FLRHW/ktest/output/reports/browse/images/cat_blender_bare_top_ktest-3D_blenderbare_top.png

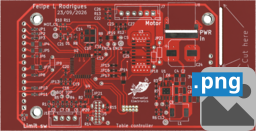
output/reports/browse/images/cat_blender_bare_top_ktest-3D_blenderbare_top.png
