FLRHW/ktest/output/reports/browse/images/cat_blender_bare_bottom_ktest-3D_blenderbare_bottom.png

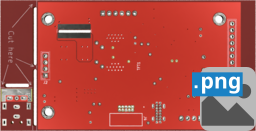
output/reports/browse/images/cat_blender_bare_bottom_ktest-3D_blenderbare_bottom.png
