FLRHW/ktest/output/reports/ktest-drc.html

Logo

(https://github.com/INTI-CMNB/KiBot/) | DRC report for ktest
| PCB: ktest Revision: 1.0.1 Date: 2026-10-10T20:06:10 KiCad Version: 10.0.5 | Errors: 0 Warnings: 4 Total: 4

Violations

Type | Description | Details
silk_over_copper | Silkscreen clipped by solder mask | @(197.425 mm, 77.951 mm): Segment of J6 on F.Silkscreen @(196.493 mm, 77.239 mm): Rectangle on F.Mask
silk_over_copper | Silkscreen clipped by solder mask | @(197.425 mm, 79.951 mm): Segment of J6 on F.Silkscreen @(196.493 mm, 77.239 mm): Rectangle on F.Mask
silk_over_copper | Silkscreen clipped by solder mask | @(186.925 mm, 79.951 mm): Segment of J6 on F.Silkscreen @(186.079 mm, 77.239 mm): Rectangle on F.Mask
silk_over_copper | Silkscreen clipped by solder mask | @(187.925 mm, 77.951 mm): Segment of J6 on F.Silkscreen @(186.079 mm, 77.239 mm): Rectangle on F.Mask

Generated by KiBot (https://github.com/INTI-CMNB/KiBot/) v1.9.1
