FLRHW/ktest/output/reports/ktest-erc.html

Logo

(https://github.com/INTI-CMNB/KiBot/) | ERC report for ktest
| Schematic: ktest Revision: 1.0.1 Date: 2026-10-10T20:06:06 KiCad Version: 10.0.5 | Errors: 0 Warnings: 0 Total: 0

✔

Generated by KiBot (https://github.com/INTI-CMNB/KiBot/) v1.9.1
