FLRHW/ktest/output/3d/ktest-3D_blenderangled_bottom.png

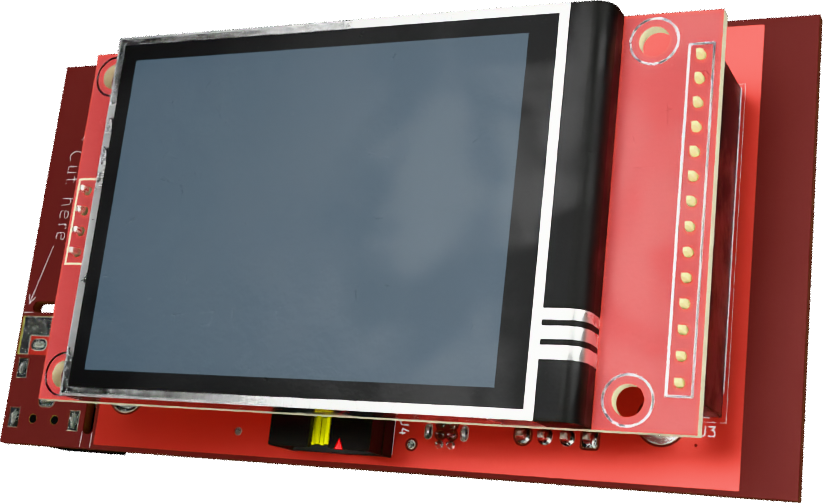
output/3d/ktest-3D_blenderangled_bottom.png
