FLRHW/ktest/output/3d/ktest-3D_blenderangled_top.png

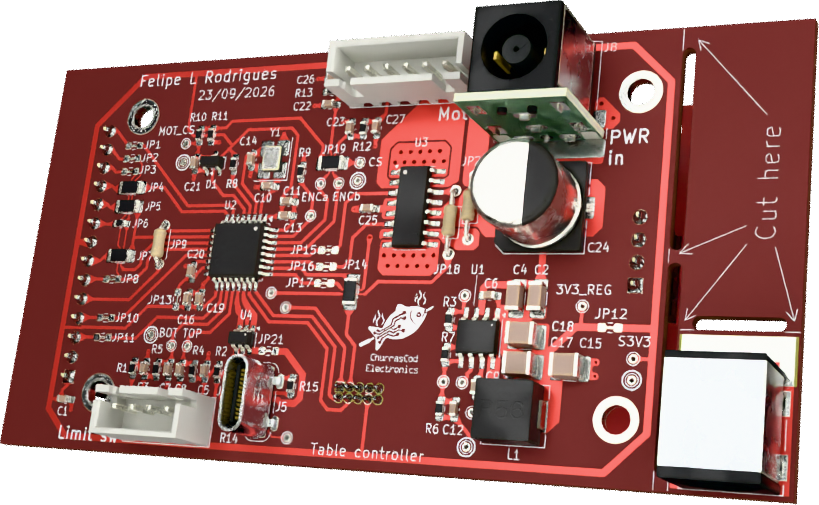
output/3d/ktest-3D_blenderangled_top.png
