FLRHW/ktest/output/3d/ktest-3D_blenderbare_bottom.png

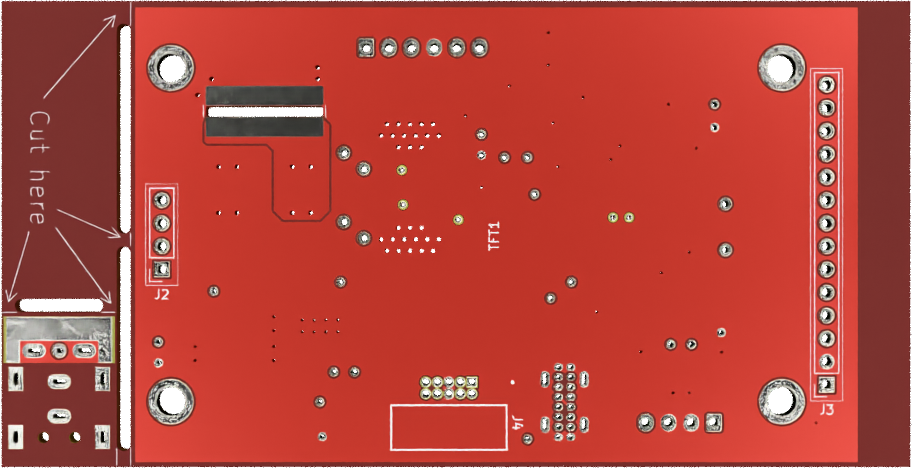
output/3d/ktest-3D_blenderbare_bottom.png
