FLRHW/ktest/output/3d/ktest-3D_blenderbare_top.png

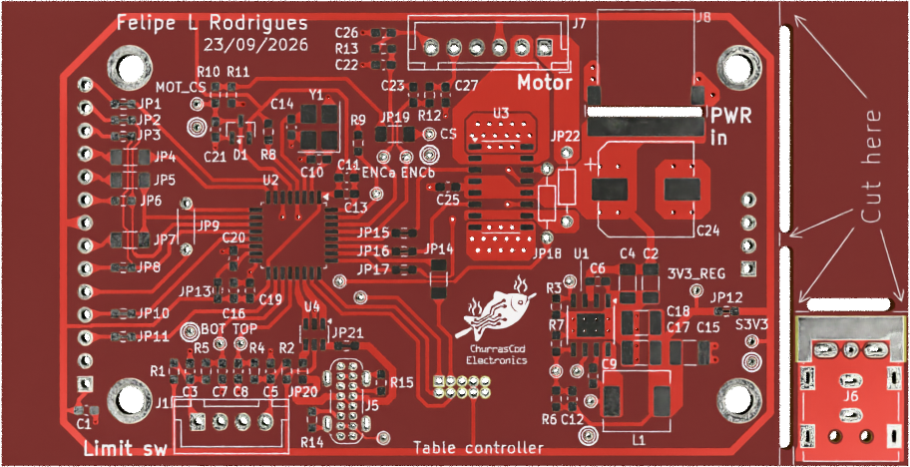
output/3d/ktest-3D_blenderbare_top.png
