FLRHW/ktest/output/3d/ktest-3D_blenderbottom.png

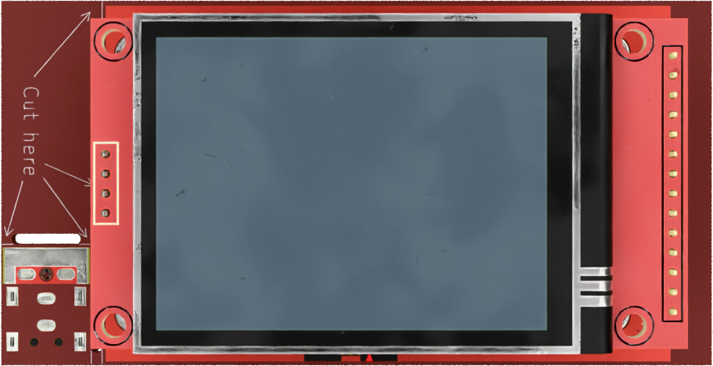
output/3d/ktest-3D_blenderbottom.png
