FLRHW/ktest/output/3d/ktest-3D_blendertop.png

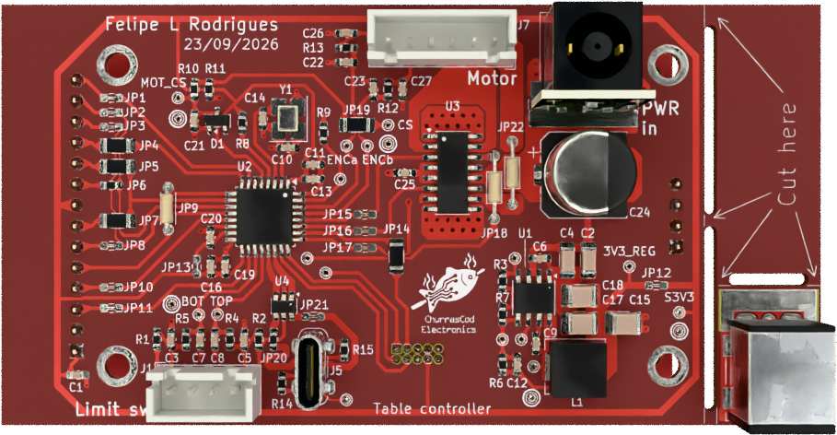
output/3d/ktest-3D_blendertop.png
