FLRHW/ktest/output/reports/browse/images/cat_blender_angled_bottom_ktest-3D_blenderangled_bottom.png

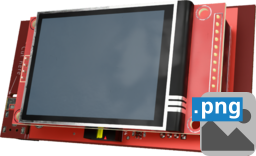
output/reports/browse/images/cat_blender_angled_bottom_ktest-3D_blenderangled_bottom.png
