FLRHW/ktest/output/reports/browse/images/cat_blender_bottom_ktest-3D_blenderbottom.png

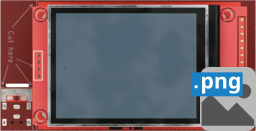
output/reports/browse/images/cat_blender_bottom_ktest-3D_blenderbottom.png
