FLRHW/ktest/output/reports/browse/images/cat_Schematic_ktest-schematic.png

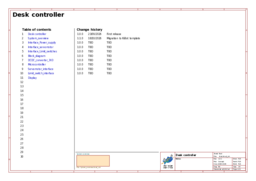
output/reports/browse/images/cat_Schematic_ktest-schematic.png
