FLRHW/ktest/output/tables/ktest-assembly-bom-bottom-fitted.csv

References | Qty | Value | Footprint | MPN | Manufacturer | Status
J2 | 1 | 01x04 socket | PinSocket_1x04_P2.54mm_Vertical | Generic | Generic
J3 | 1 | 01x14 socket | PinSocket_1x14_P2.54mm_Vertical | Generic | Generic
J4 | 1 | HX JN1.27-2x5 WZ H4.9 | JN1.27-2x5 WZ H4.9 | Hanxia | HX JN1.27-2x5 WZ H4.9
TFT1 | 1 | TFT_2.4in_320x240 | Display_240x320_ILI9341_2.4in_no_pads | ILI9341_320x240 | TENSTAR ROBOT
