FLRHW/ktest/output/tables/ktest-assembly-bom-top-fitted.csv

References | Qty | Value | Footprint | MPN | Manufacturer | Status
C1 C6 C9 C13 C19 C20 C25 | 7 | 100n | C_0603_1608Metric_Pad1.08x0.95mm_HandSolder | AC0603KRX7R9BB104 | Yageo
C3 C5 C26 C27 | 4 | 10n | C_0603_1608Metric_Pad1.08x0.95mm_HandSolder | AC0603KRX7R9BB103 | Yageo
C7 C8 C21 C22 C23 | 5 | 1n | C_0603_1608Metric_Pad1.08x0.95mm_HandSolder | AC0603KRX7R9BB102 | Yageo
C11 C16 | 2 | 1u | C_0603_1608Metric_Pad1.08x0.95mm_HandSolder | AC0603KRX7R7BB105 | Yageo
C24 | 1 | 220u | CP_Elec_10x10 | EEE-FK1H221P | Panasonic
C10 C14 | 2 | 22p | C_0603_1608Metric_Pad1.08x0.95mm_HandSolder | AC0603JRNPO9BN220 | Yageo
C15 C17 C18 | 3 | 22u | C_1210_3225Metric_Pad1.33x2.70mm_HandSolder | MCAST32MSB7226KPNA01 | TAIYO YUDEN
C12 | 1 | 33p | C_0603_1608Metric_Pad1.08x0.95mm_HandSolder | AC0603JRNPO9BN330 | Yageo
C2 C4 | 2 | 4.7u | C_1206_3216Metric_Pad1.33x1.80mm_HandSolder | C1206C475K5RACAUTO | KEMET
D1 | 1 | BAV99 | SOT-23 | BAV99Q-7-F | Diodes Inc
J1 | 1 | B4B XH A | JST_XH_B4B-XH-A_1x04_P2.50mm_Vertical | B4B XH A | JST
J7 | 1 | B6B XH A | JST_XH_B6B-XH-A_1x06_P2.50mm_Vertical | B6B XH A | JST
J8 | 1 | DC barrel assy | Dell_barrel_assy | NA | NA
J6 | 1 | Dell DC jack | Dell DC jack | Barrel jack | Dell
J5 | 1 | USB_C_Receptacle_USB2.0_16P | USB_C_socket_16P_vertical | TFKH5-16L4CC-65 | ChengHaoRan
JP4 JP5 JP7 JP14 JP19 | 5 | 0R | R_1206_3216Metric_Pad1.30x1.75mm_HandSolder | Hand cut wire | Generic
JP18 JP22 | 2 | 0R | R_Axial_DIN0204_L3.6mm_D1.6mm_P7.62mm_Horizontal | Hand cut wire | Generic
JP6 JP20 | 2 | 0R | R_0603_1608Metric_Pad0.98x0.95mm_HandSolder | RC0603JR-130RP | Yageo
JP9 | 1 | 0R | R_Axial_DIN0204_L3.6mm_D1.6mm_P5.08mm_Horizontal | Hand cut wire | Generic
L1 | 1 | 10u | L_Bourns_SRP6540 | SRP6540-100M | Bourns
R1 R2 R7 R8 R9 | 5 | 10k | R_0603_1608Metric_Pad0.98x0.95mm_HandSolder | AC0603FR-0710KL | YAGEO
R6 | 1 | 23.2k | R_0603_1608Metric_Pad0.98x0.95mm_HandSolder | AC0603FR-0723K2L | YAGEO
R4 R5 R10 R12 R13 | 5 | 2k2 | R_0603_1608Metric_Pad0.98x0.95mm_HandSolder | AC0603FR-072K2L | YAGEO
R14 R15 | 2 | 5k1 | R_0603_1608Metric_Pad0.98x0.95mm_HandSolder | AC0603FR-075K1L | YAGEO
R3 | 1 | 64.9k | R_0603_1608Metric_Pad0.98x0.95mm_HandSolder | AC0603FR-0764K9L | YAGEO
R11 | 1 | 820 | R_0603_1608Metric_Pad0.98x0.95mm_HandSolder | AC0603FR-07820RL | YAGEO
U1 | 1 | LMR38020 | Texas_HSOP-8-1EP_3.9x4.9mm_P1.27mm_ThermalVias | LMR38020FDDAR | Texas instruments
U2 | 1 | STM32G431K8T | LQFP-32_7x7mm_P0.8mm | STM32G431K8T6 | ST
U4 | 1 | USBLC6-2SC6 | SOT-23-6 | USBLC6-2SC6 | ST
U3 | 1 | VNH7070 | JEITA_SOIC-16_3.9x9.9mm_P1.27mm | VNH7070 | ST
Y1 | 1 | 20 MHz | Crystal_SMD_3225-4Pin_3.2x2.5mm_HandSoldering | CX3225SB20000H0FLJCC | KYOCERA AVX
