FLRHW/ktest/output/assembly/ktest-pcb-assembly.pdf

# Desk controller assembly drawing

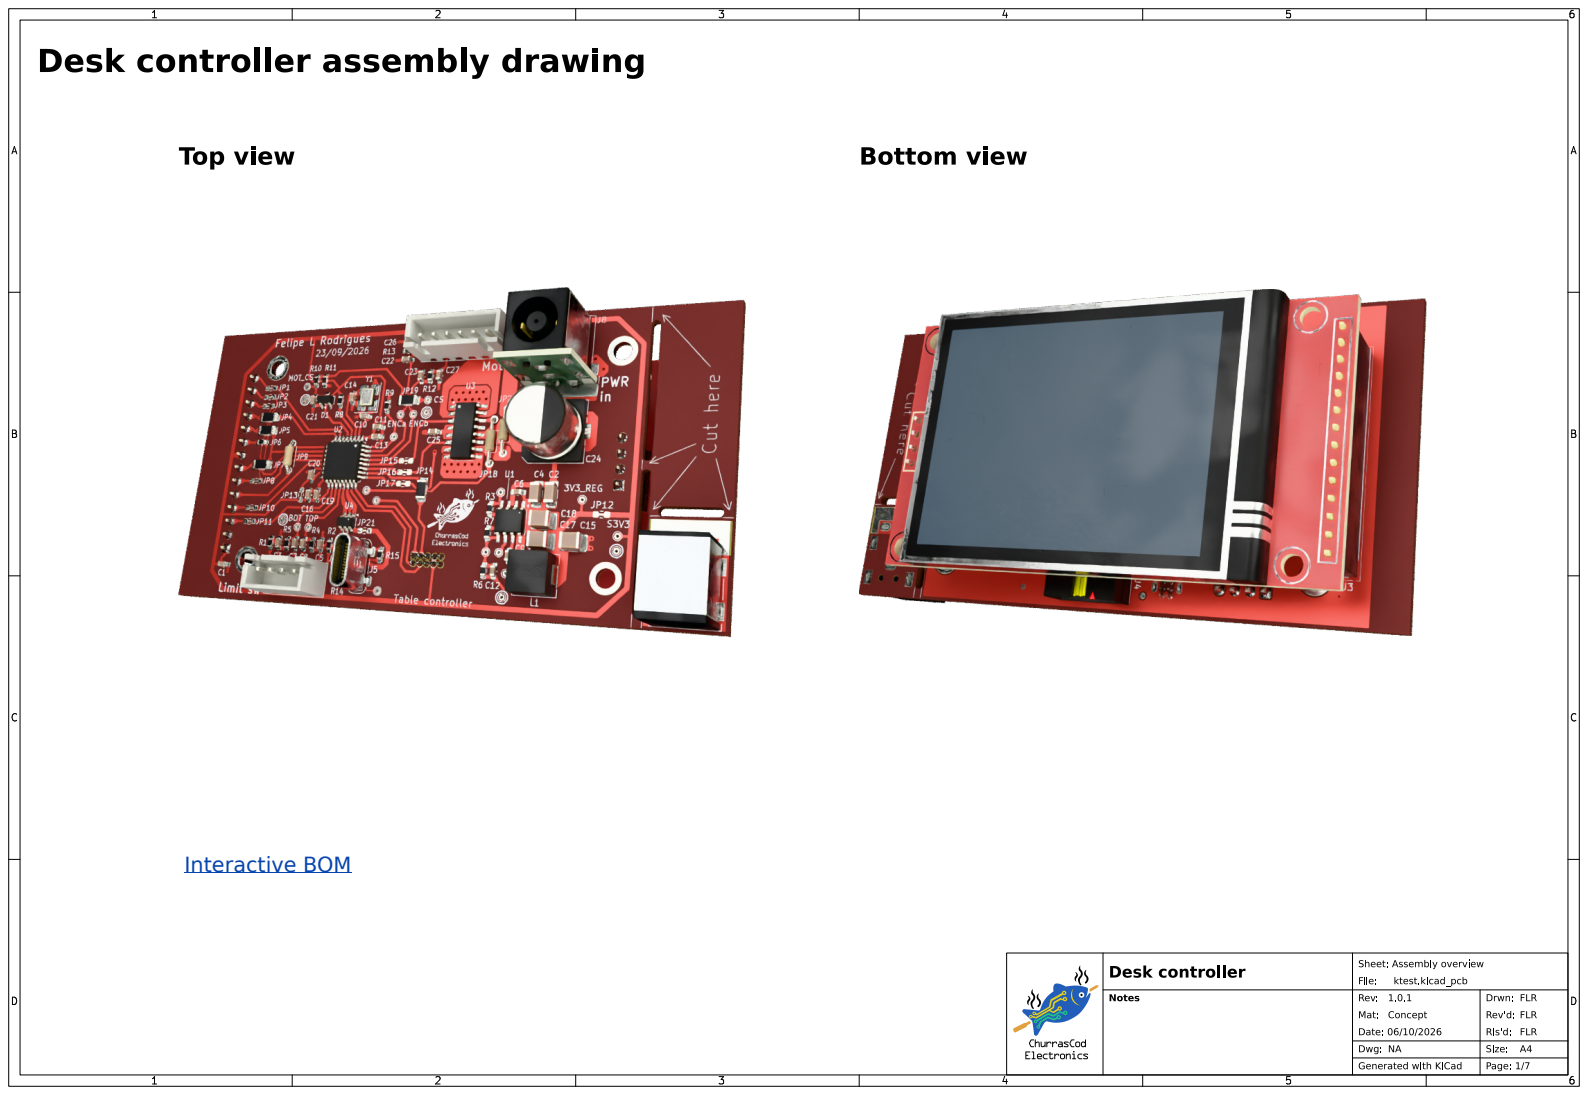
[picture p13: page 1]
ktest.kicad_pcb; FLR; Rev'd:; Drwn:; Desk controller; Rls'd:; Concept; Notes; Size:; Interactive BOM

Sheet: Assembly overview
File:
Rev:
Mat:
Date: 06/10/2026
Dwg: NA
Generated with KiCad

# Top assembly (Scale 1:1)

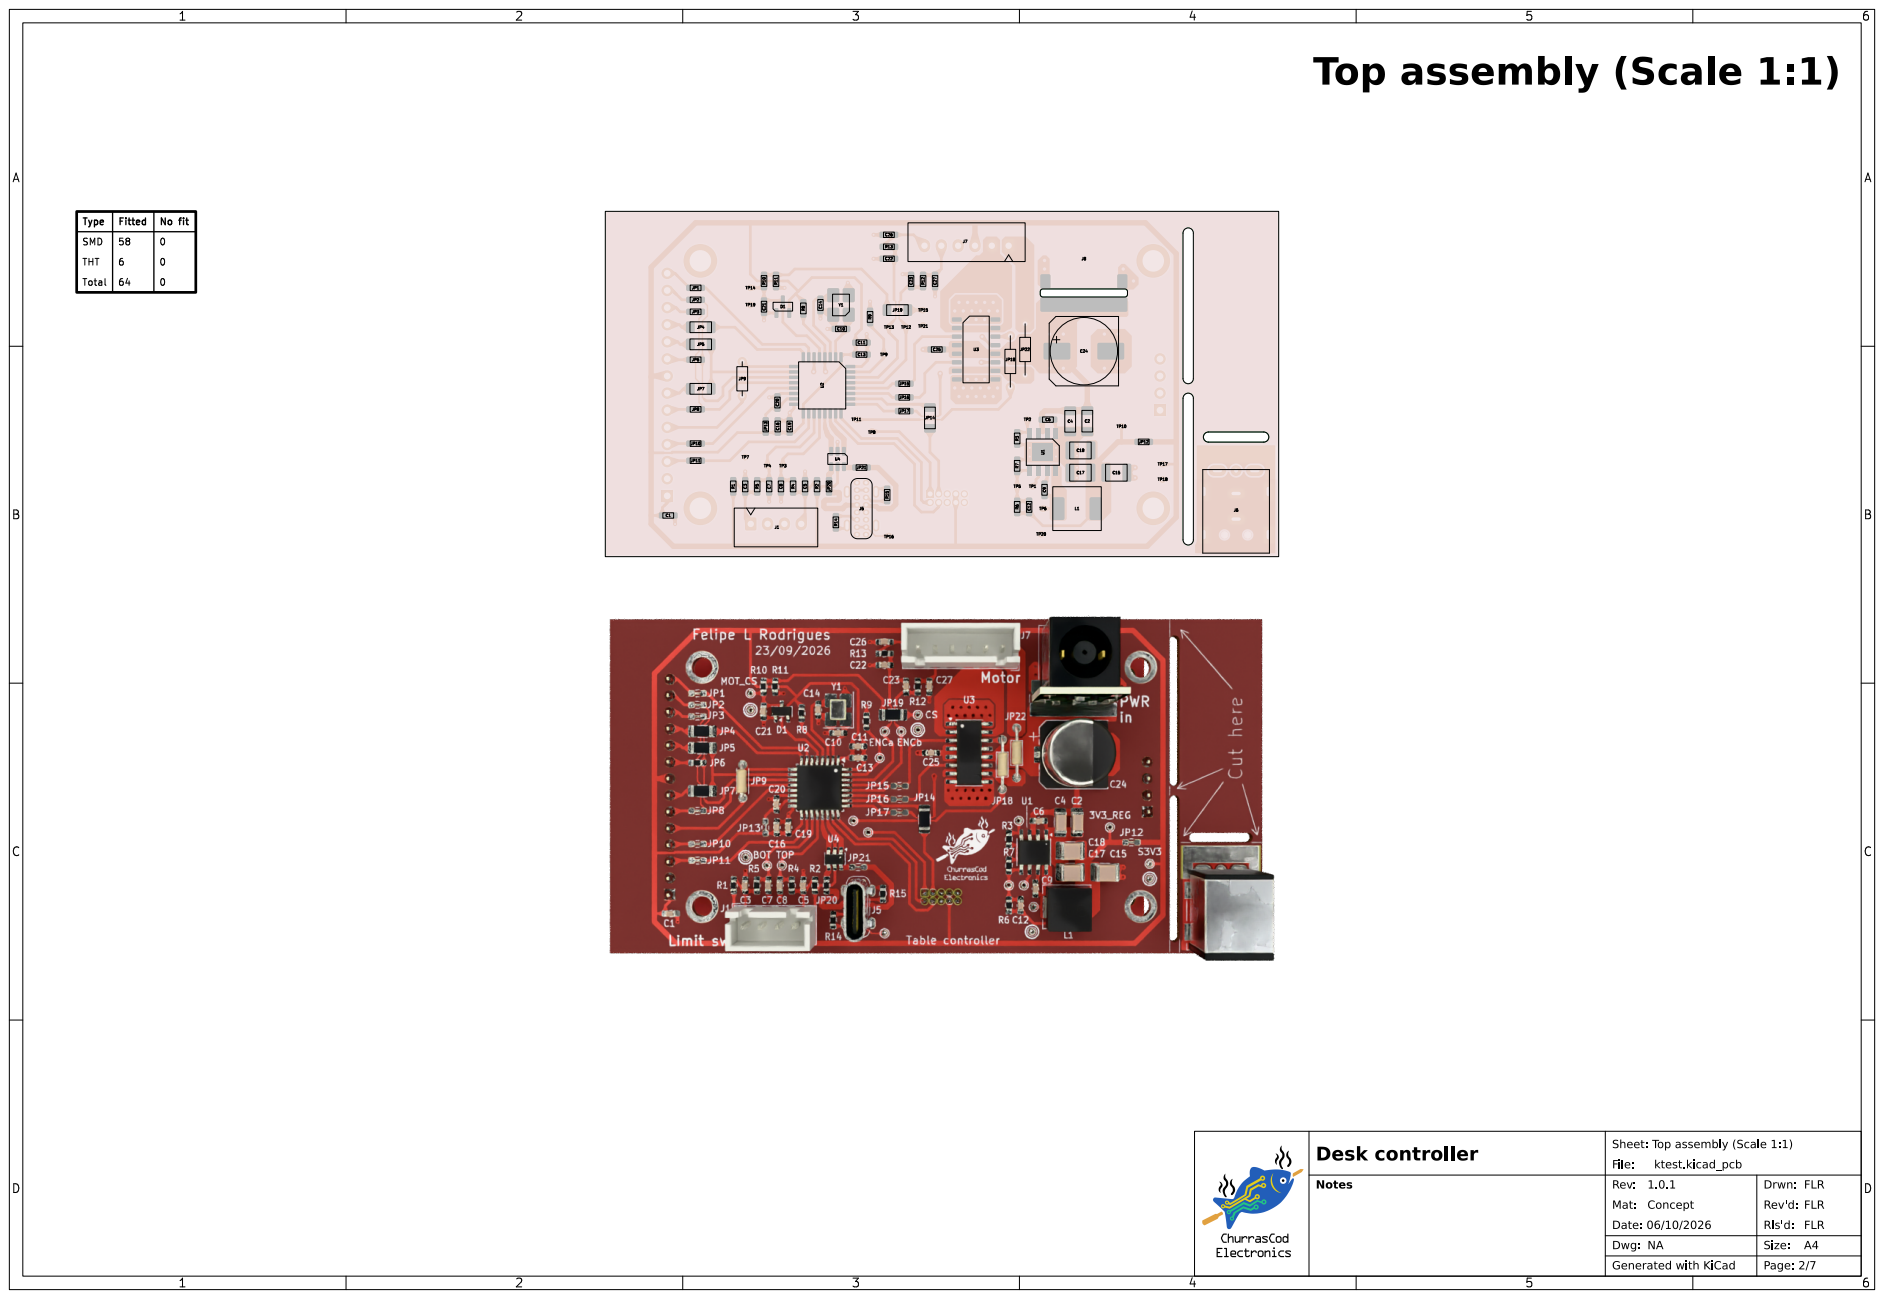
[picture p14: page 2]

# Bottom assembly (Scale 1:1)

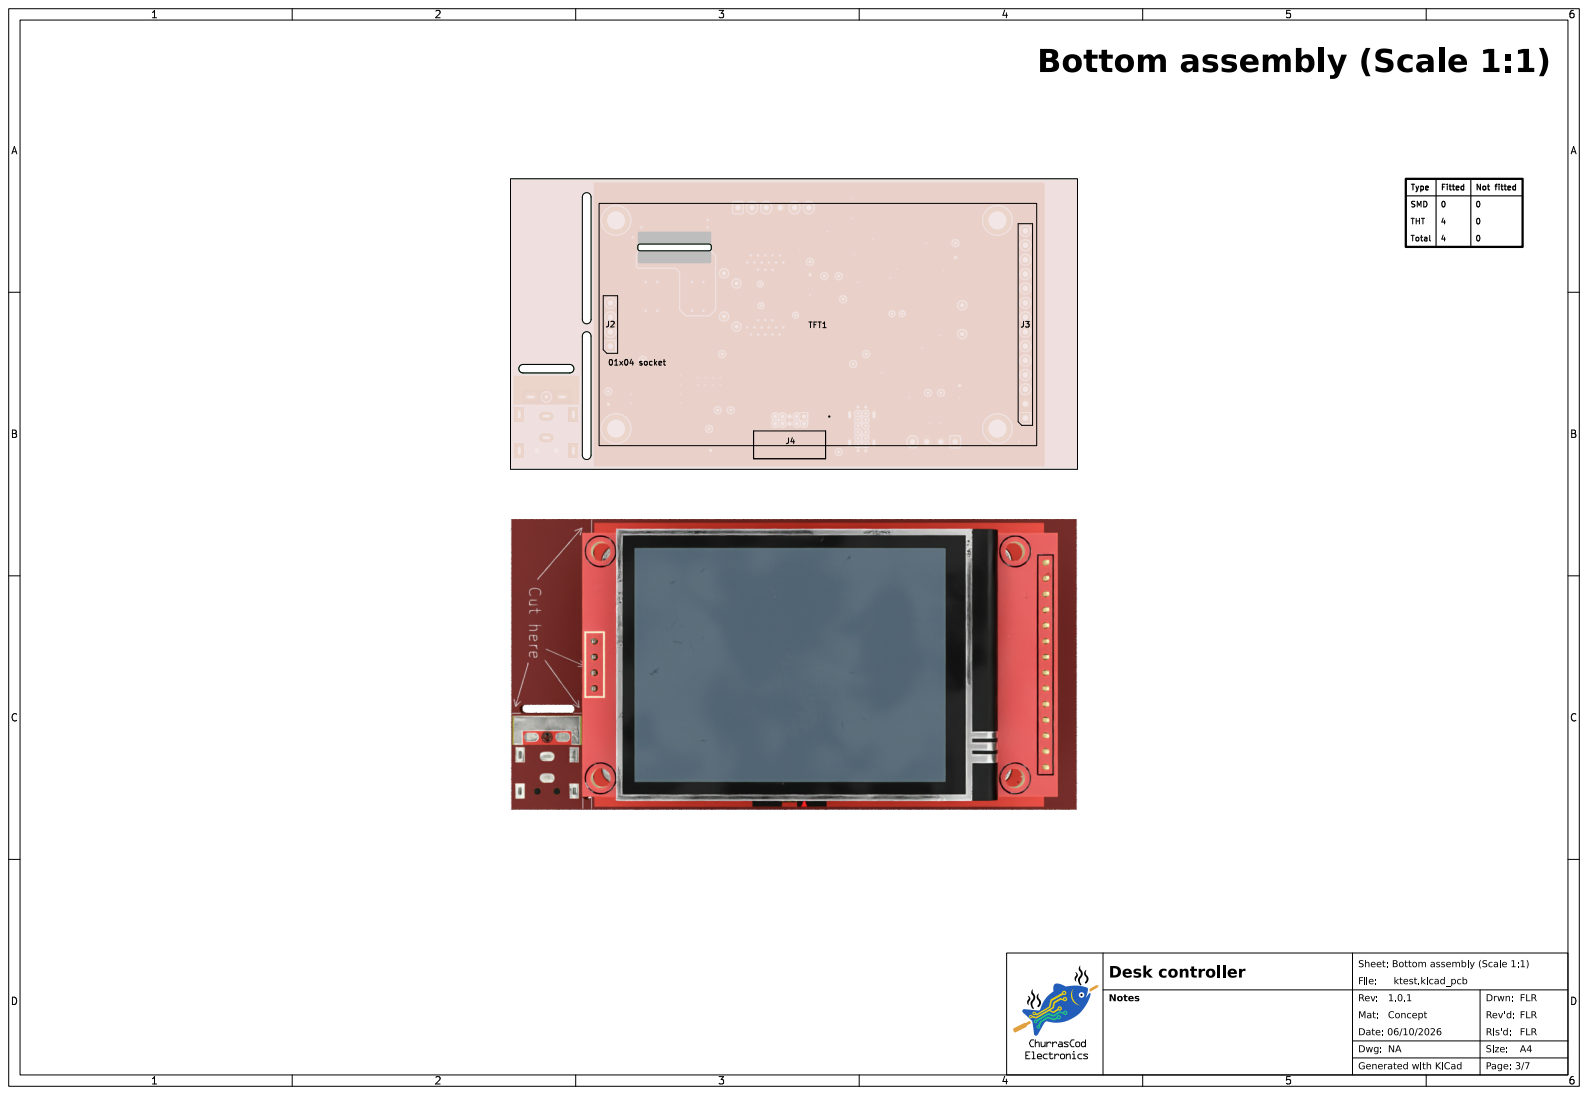
[picture p15: page 3]
Mat:; ktest.kicad_pcb; FLR; Rev'd:; Drwn:; Desk controller; Rls'd:; Concept; Notes; Sheet: Bottom assembly (Scale 1:1); File:; Rev:; Date: 06/10/2026; FittedType; Not fitted; SMD; THT; Total; TFT1; 01x04 socket

# Top BOM - fitted (1 of 3)

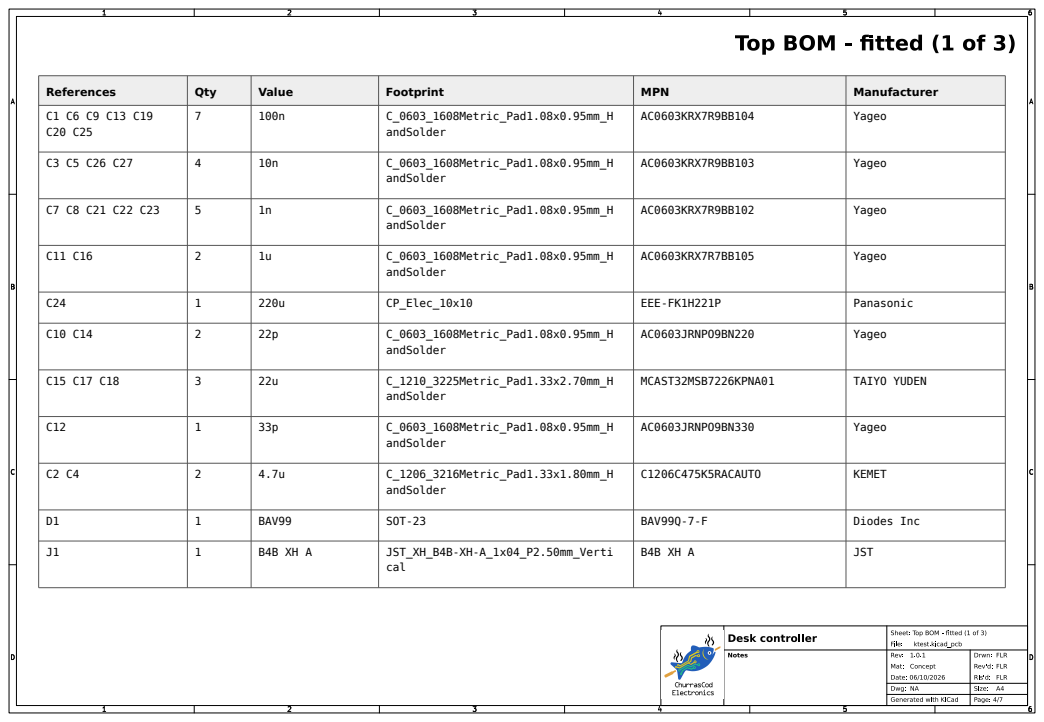
[picture p16: page 4]

References | Qty | Value | Footprint | MPN | Manufacturer
C1 C6 C9 C13 C19 C20 C25 | 7 | 100n | C_0603_1608Metric_Pad1.08x0.95mm_H andSolder | AC0603KRX7R9BB104 | Yageo

C3 C5 C26 C27 | 4 | 10n | C_0603_1608Metric_Pad1.08x0.95mm_H andSolder | AC0603KRX7R9BB103 | Yageo

C7 C8 C21 C22 C23 | 5 | 1n | C_0603_1608Metric_Pad1.08x0.95mm_H andSolder | AC0603KRX7R9BB102 | Yageo

C11 C16 | 2 | 1u | C_0603_1608Metric_Pad1.08x0.95mm_H andSolder | AC0603KRX7R7BB105 | Yageo

C24 | 1 | 220u | CP_Elec_10x10 | EEE-FK1H221P | Panasonic

C10 C14 | 2 | 22p | C_0603_1608Metric_Pad1.08x0.95mm_H andSolder | AC0603JRNPO9BN220 | Yageo

C15 C17 C18 | 3 | 22u | C_1210_3225Metric_Pad1.33x2.70mm_H andSolder | MCAST32MSB7226KPNA01 | TAIYO YUDEN

C12 | 1 | 33p | C_0603_1608Metric_Pad1.08x0.95mm_H andSolder | AC0603JRNPO9BN330 | Yageo

C2 C4 | 2 | 4.7u | C_1206_3216Metric_Pad1.33x1.80mm_H andSolder | C1206C475K5RACAUTO | KEMET

D1 | 1 | BAV99 | SOT-23 | BAV99Q-7-F | Diodes Inc

J1 | 1 | B4B XH A | JST_XH_B4B-XH-A_1x04_P2.50mm_Verti cal | B4B XH A | JST

# Top BOM - fitted (2 of 3)

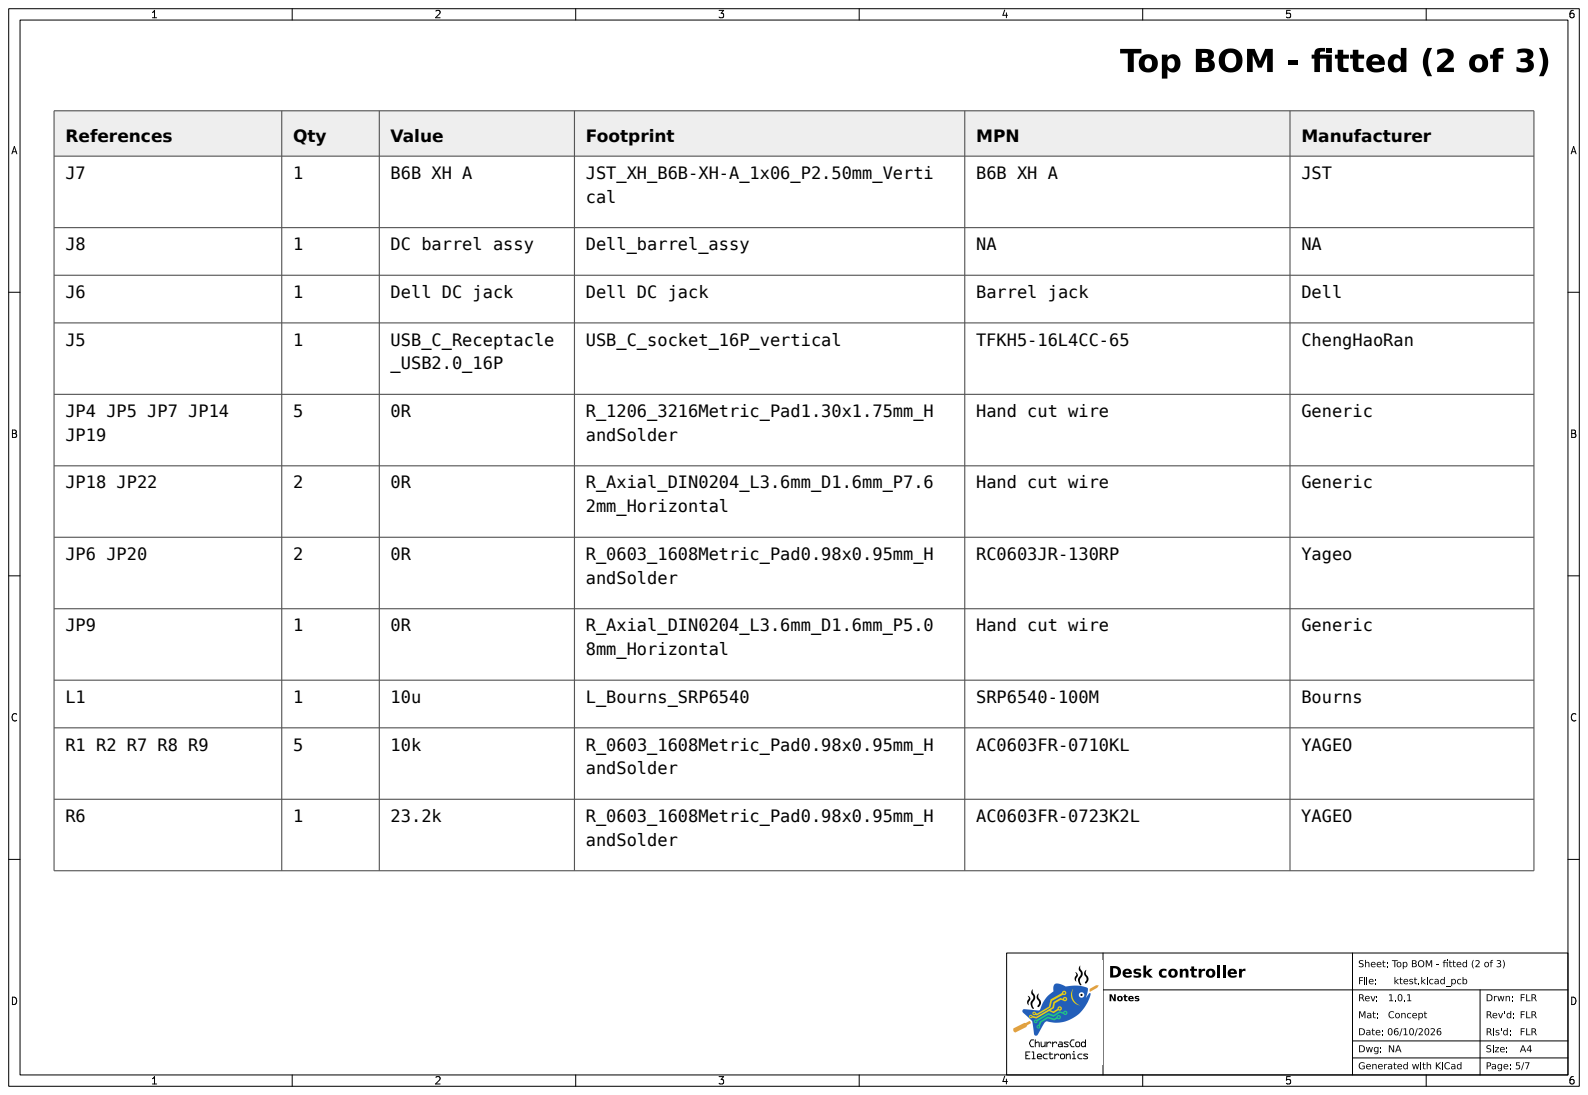
[picture p17: page 5]

References | Qty | Value | Footprint | MPN | Manufacturer
J7 | 1 | B6B XH A | JST_XH_B6B-XH-A_1x06_P2.50mm_Verti cal | B6B XH A | JST

J8 | 1 | DC barrel assy | Dell_barrel_assy | NA | NA

J6 | 1 | Dell DC jack | Dell DC jack | Barrel jack | Dell

J5 | 1 | USB_C_Receptacle _USB2.0_16P | USB_C_socket_16P_vertical | TFKH5-16L4CC-65 | ChengHaoRan

JP4 JP5 JP7 JP14 JP19 | 5 | 0R | R_1206_3216Metric_Pad1.30x1.75mm_H andSolder | Hand cut wire | Generic

JP18 JP22 | 2 | 0R | R_Axial_DIN0204_L3.6mm_D1.6mm_P7.6 2mm_Horizontal | Hand cut wire | Generic

JP6 JP20 | 2 | 0R | R_0603_1608Metric_Pad0.98x0.95mm_H andSolder | RC0603JR-130RP | Yageo

JP9 | 1 | 0R | R_Axial_DIN0204_L3.6mm_D1.6mm_P5.0 8mm_Horizontal | Hand cut wire | Generic

L1 | 1 | 10u | L_Bourns_SRP6540 | SRP6540-100M | Bourns

R1 R2 R7 R8 R9 | 5 | 10k | R_0603_1608Metric_Pad0.98x0.95mm_H andSolder | AC0603FR-0710KL | YAGEO

R6 | 1 | 23.2k | R_0603_1608Metric_Pad0.98x0.95mm_H andSolder | AC0603FR-0723K2L | YAGEO

# Top BOM - fitted (3 of 3)

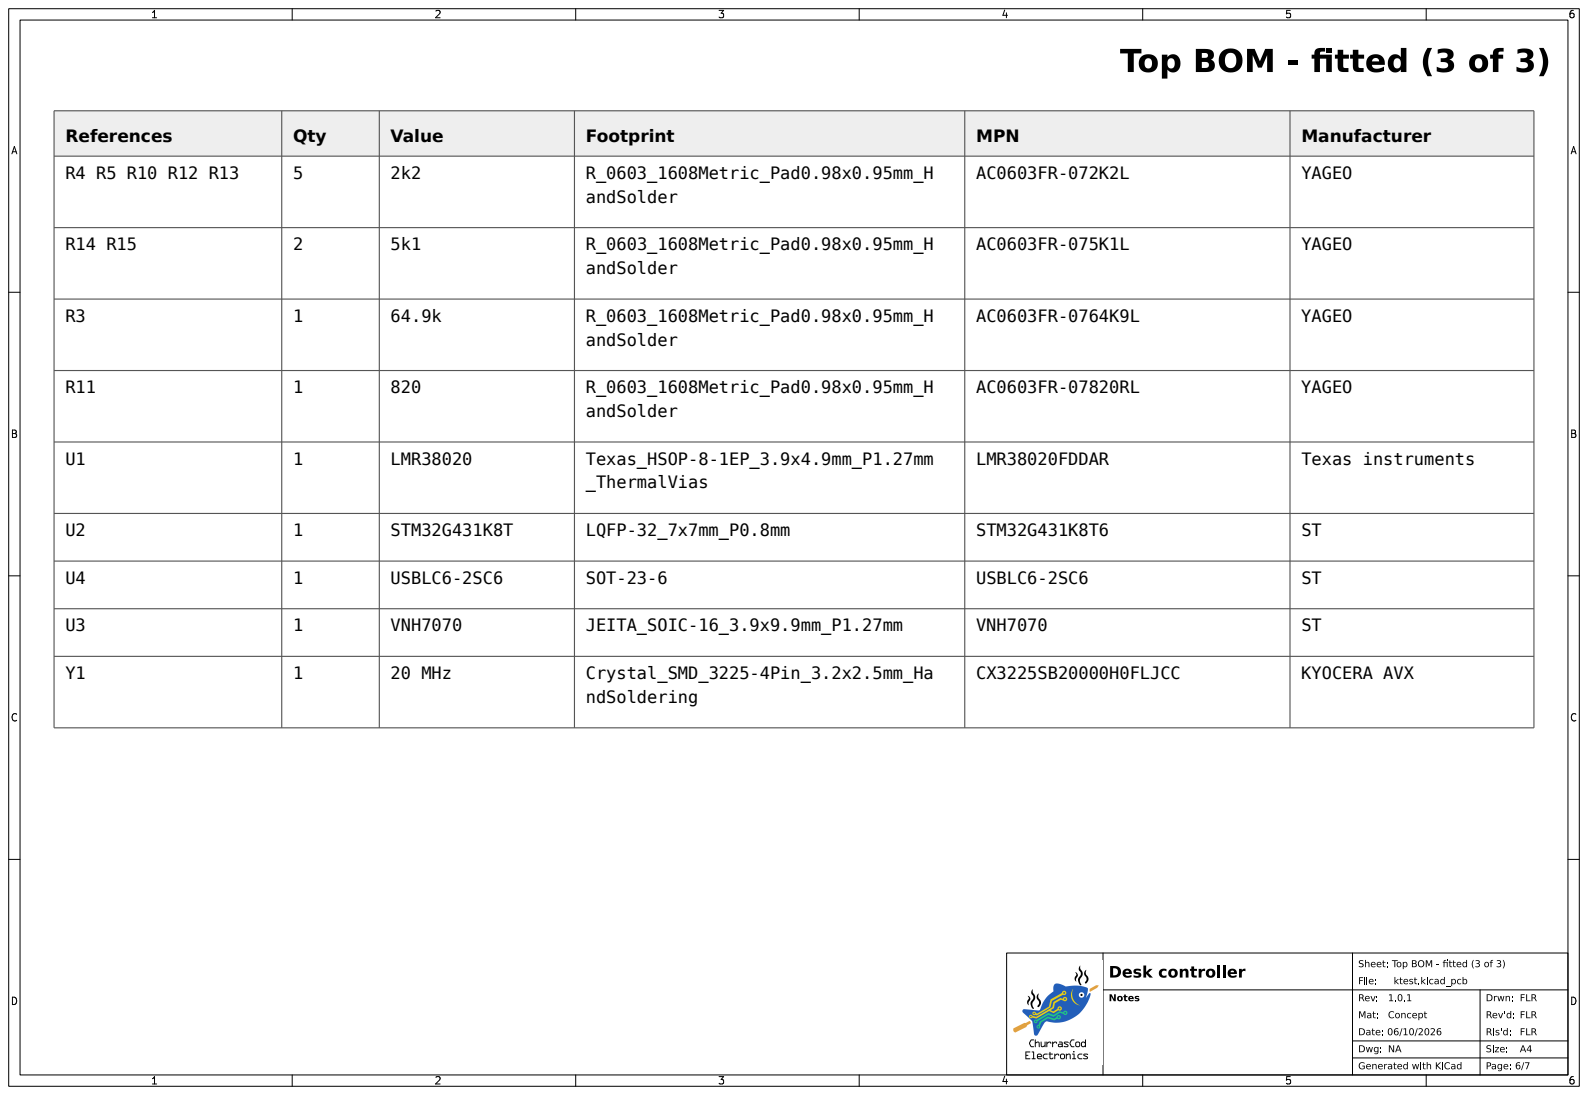
[picture p18: page 6]

References | Qty | Value | Footprint | MPN | Manufacturer
R4 R5 R10 R12 R13 | 5 | 2k2 | R_0603_1608Metric_Pad0.98x0.95mm_H andSolder | AC0603FR-072K2L | YAGEO

R14 R15 | 2 | 5k1 | R_0603_1608Metric_Pad0.98x0.95mm_H andSolder | AC0603FR-075K1L | YAGEO

R3 | 1 | 64.9k | R_0603_1608Metric_Pad0.98x0.95mm_H andSolder | AC0603FR-0764K9L | YAGEO

R11 | 1 | 820 | R_0603_1608Metric_Pad0.98x0.95mm_H andSolder | AC0603FR-07820RL | YAGEO

U1 | 1 | LMR38020 | Texas_HSOP-8-1EP_3.9x4.9mm_P1.27mm _ThermalVias | LMR38020FDDAR | Texas instruments

U2 | 1 | STM32G431K8T | LQFP-32_7x7mm_P0.8mm | STM32G431K8T6 | ST

U4 | 1 | USBLC6-2SC6 | SOT-23-6 | USBLC6-2SC6 | ST

U3 | 1 | VNH7070 | JEITA_SOIC-16_3.9x9.9mm_P1.27mm | VNH7070 | ST

Y1 | 1 | 20 MHz | Crystal_SMD_3225-4Pin_3.2x2.5mm_Ha ndSoldering | CX3225SB20000H0FLJCC | KYOCERA AVX

# Bottom BOM - fitted (1 of 1)

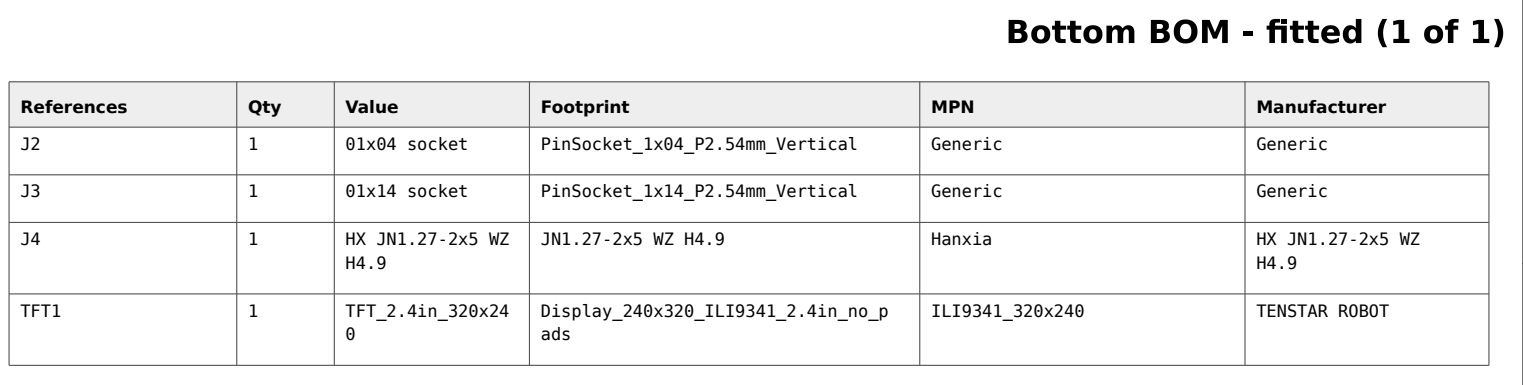
[picture p19: page 7]
ktest.kicad_pcb; FLR; Rev'd:; Drwn:; Desk controller; Rls'd:; Concept; Notes

References | Qty | Value | Footprint | MPN | Manufacturer
J2 | 1 | 01x04 socket | PinSocket_1x04_P2.54mm_Vertical | Generic | Generic

J3 | 1 | 01x14 socket | PinSocket_1x14_P2.54mm_Vertical | Generic | Generic

J4 | 1 | HX JN1.27-2x5 WZ H4.9 | JN1.27-2x5 WZ H4.9 | Hanxia | HX JN1.27-2x5 WZ H4.9

TFT1 | 1 | TFT_2.4in_320x24 0 | Display_240x320_ILI9341_2.4in_no_p ads | ILI9341_320x240 | TENSTAR ROBOT

Sheet: Bottom BOM - fitted (1 of 1)
File:
Rev:
Mat:
Date: 06/10/2026
