FLRHW/ktest/output/fabrication/ktest-pcb-fabrication.pdf

# Desk controller fabrication drawing

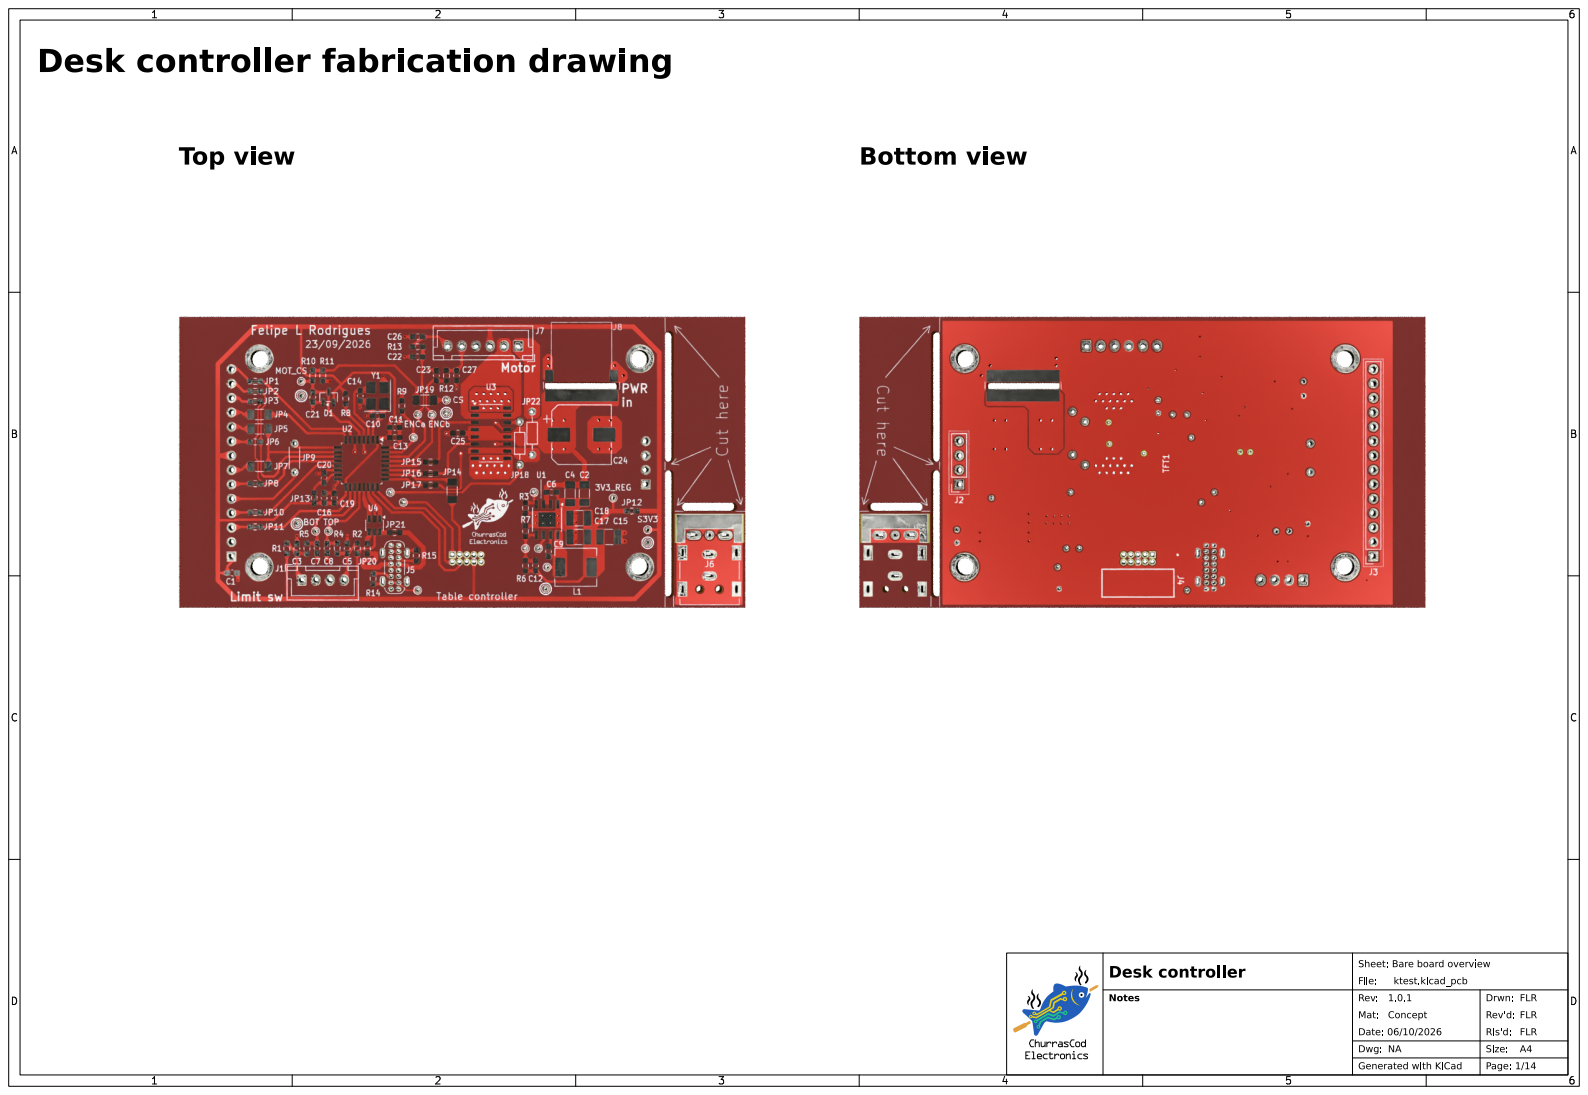
[picture p20: page 1]
ktest.kicad_pcb; FLR; Rev'd:; Drwn:; Desk controller; Rls'd:; Concept; Notes; Size:

Sheet: Bare board overview
File:
Rev:
Mat:
Date: 06/10/2026
Dwg: NA
Generated with KiCad

# Fabrication requirements

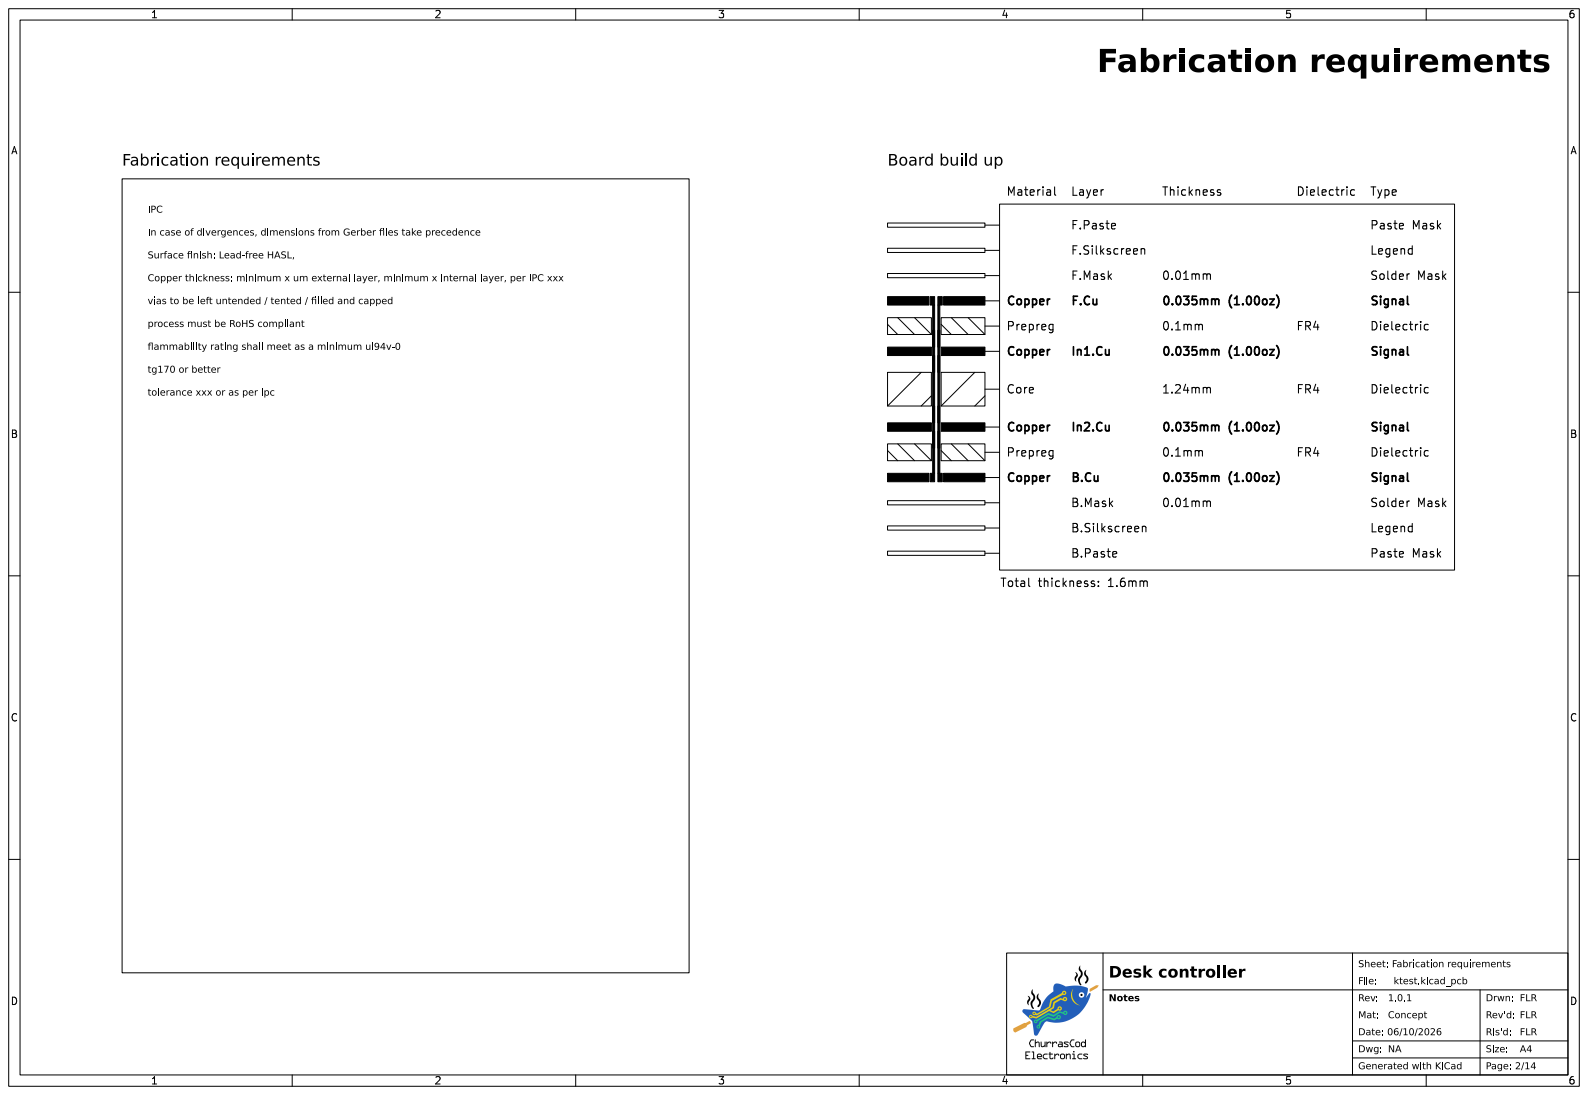
[picture p21: page 2]
Mat:; ktest.kicad_pcb; FLR; Rev'd:; Drwn:; Desk controller; Rls'd:; Concept; Notes; Sheet: Fabrication requirements; File:; Rev:; Date: 06/10/2026; F.Paste; Paste Mask; F.Silkscreen; Legend; F.Mask; Solder; Mask; Copper; Signal; Prepreg; Dielectric; Core; B.Mask; B.Silkscreen; B.Paste; Material; Layer; Thickness; Dielectric Type; Total thickness:

# Top fabrication (scale 1:1)

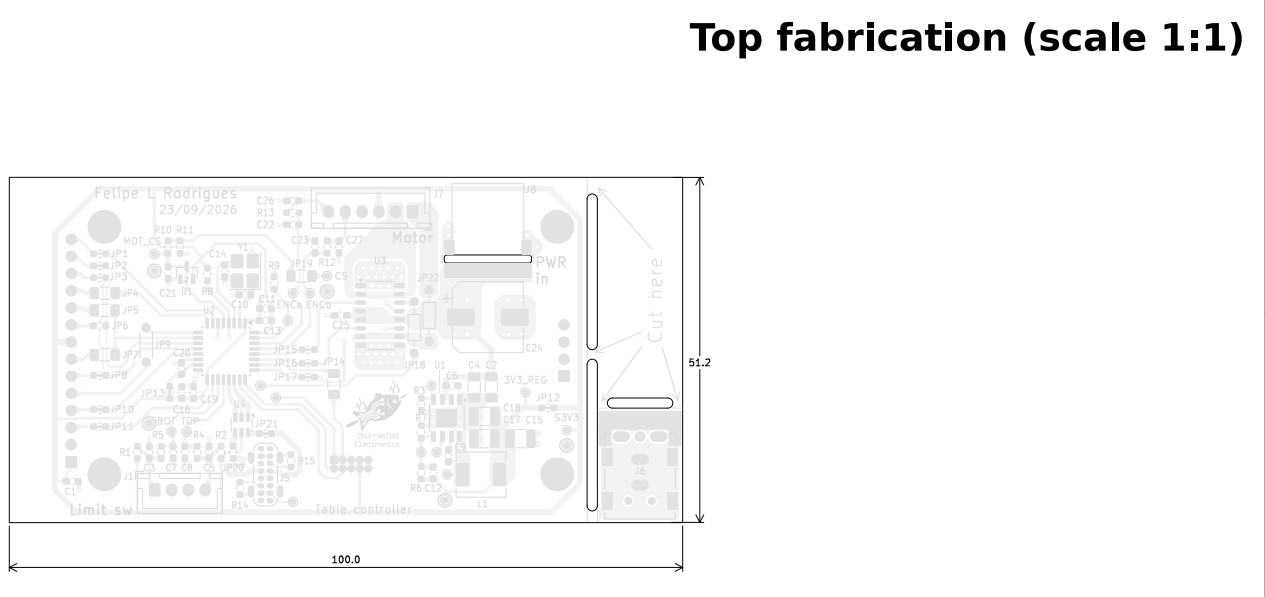
[picture p22: page 3]

# Bottom fabrication (scale 1:1)

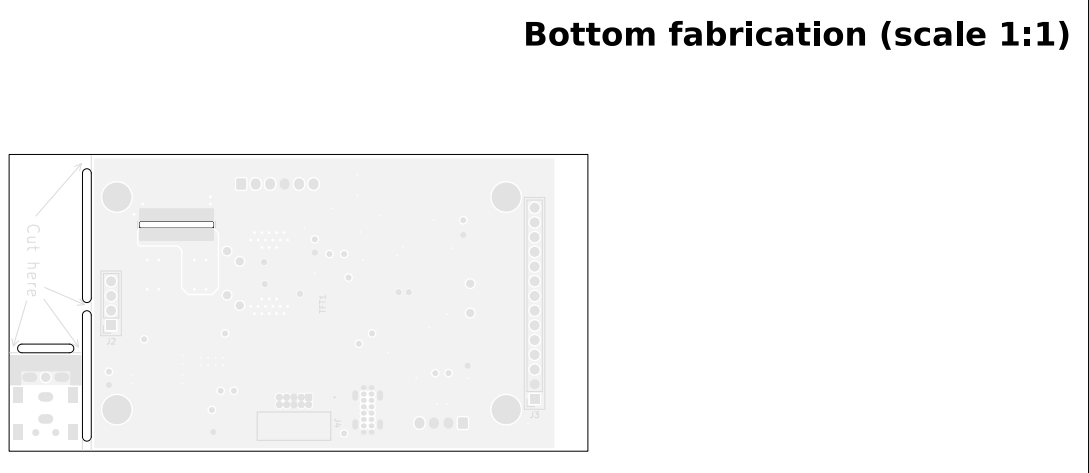
[picture p23: page 4]
Mat:; ktest.kicad_pcb; FLR; Rev'd:; Drwn:; Desk controller; Rls'd:; Concept; Notes; Sheet: Bottom fabrication (scale 1:1); File:; Rev:; Date: 06/10/2026; 6 TFT1; Cut here

# Drill drawing — L1 - L4 (scale 1:1)

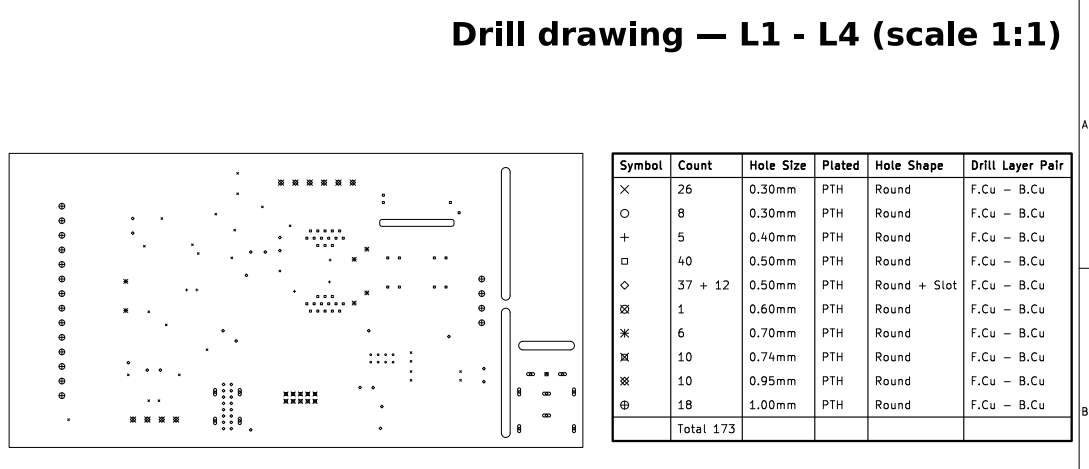
[picture p24: page 5]
Mat:; ktest.kicad_pcb; FLR; Rev'd:; Drwn:; Desk controller; Rls'd:; Concept; Notes; Sheet: Drill drawing — L1 - L4 (scale 1:1); File:; Rev:; Date: 06/10/2026; Symbol; Count; Hole Size; Plated; Hole Shape; Drill Layer Pair; Total 173; PTH; Round; Round + Slot

# Drill drawing — L1 - L4 (scale 1:1)

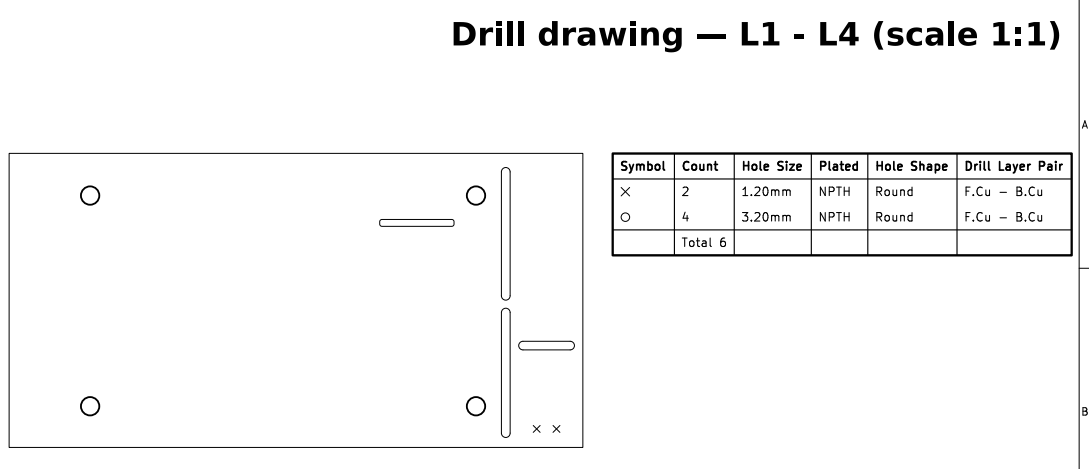
[picture p25: page 6]
Mat:; ktest.kicad_pcb; FLR; Rev'd:; Drwn:; Desk controller; Rls'd:; Concept; Notes; Sheet: Drill drawing — L1 - L4 (scale 1:1); File:; Rev:; Date: 06/10/2026; Symbol; Count; Hole Size; Plated; Hole Shape; Drill; Layer; Pair; Total 6; NPTH; Round

# F.Cu (scale 1:1)

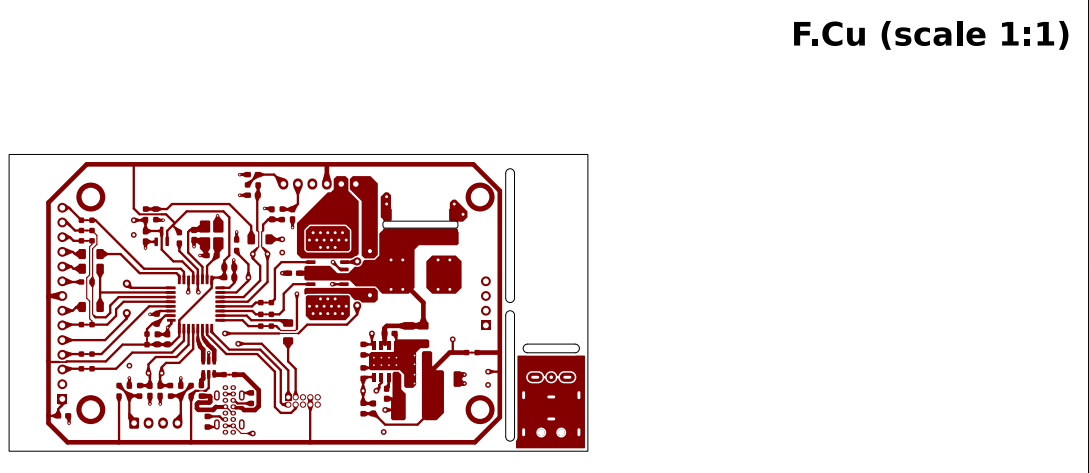
[picture p26: page 7]
Mat:; ktest.kicad_pcb; FLR; Rev'd:; Drwn:; Desk controller; Rls'd:; Concept; Notes; Sheet: F.Cu (scale 1:1); File:; Rev:; Date: 06/10/2026

# In1.Cu (scale 1:1)

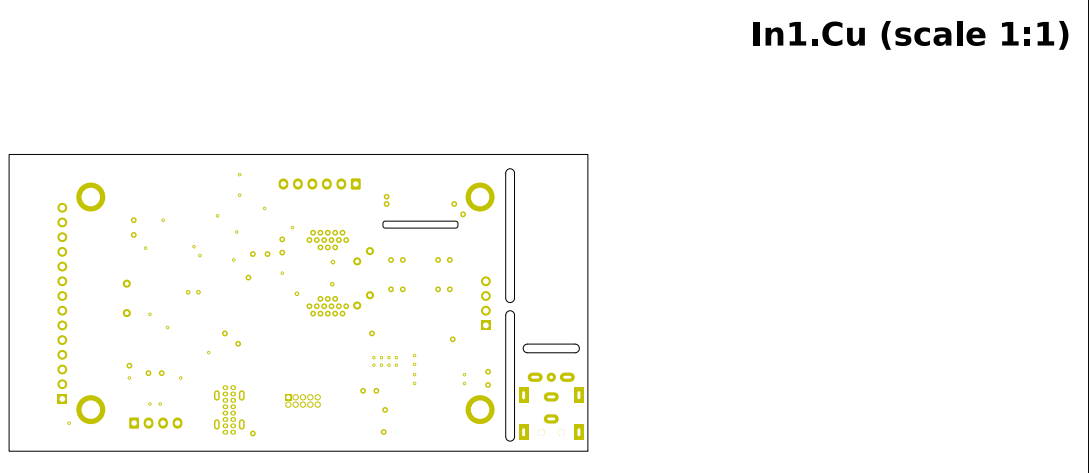
[picture p27: page 8]
Mat:; ktest.kicad_pcb; FLR; Rev'd:; Drwn:; Desk controller; Rls'd:; Concept; Notes; Sheet: In1.Cu (scale 1:1); File:; Rev:; Date: 06/10/2026

# In2.Cu (scale 1:1)

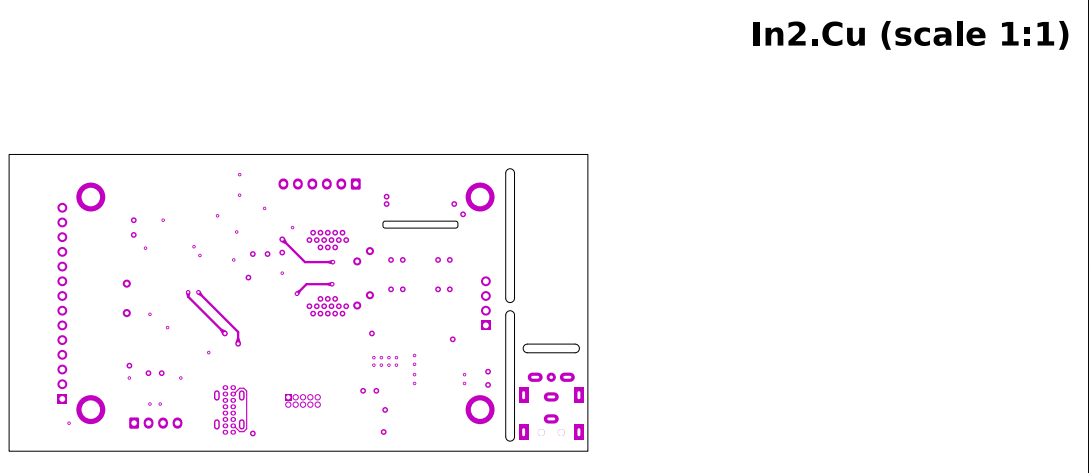
[picture p28: page 9]
Mat:; ktest.kicad_pcb; FLR; Rev'd:; Drwn:; Desk controller; Rls'd:; Concept; Notes; Sheet: In2.Cu (scale 1:1); File:; Rev:; Date: 06/10/2026

# B.Cu (scale 1:1)

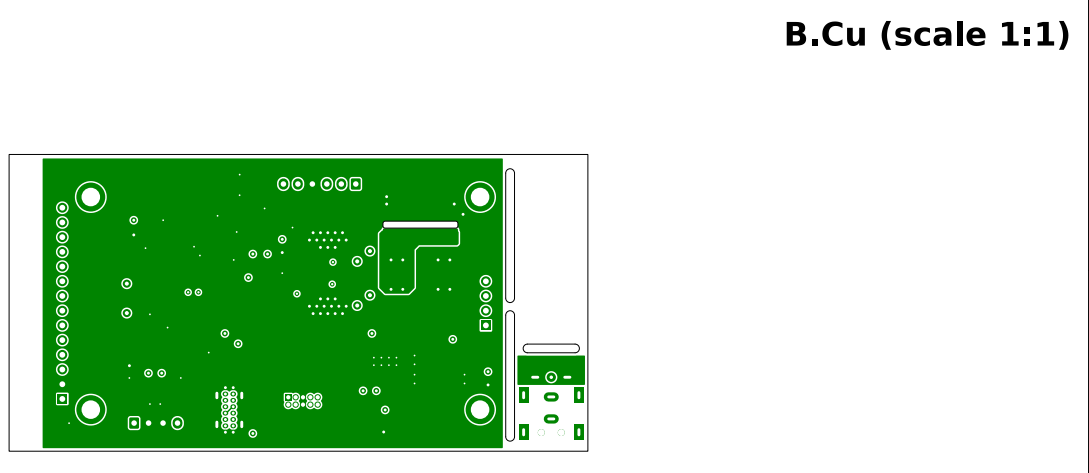
[picture p29: page 10]
Mat:; ktest.kicad_pcb; FLR; Rev'd:; Drwn:; Desk controller; Rls'd:; Concept; Notes; Sheet: B.Cu (scale 1:1); File:; Rev:; Date: 06/10/2026

# F.Mask (scale 1:1)

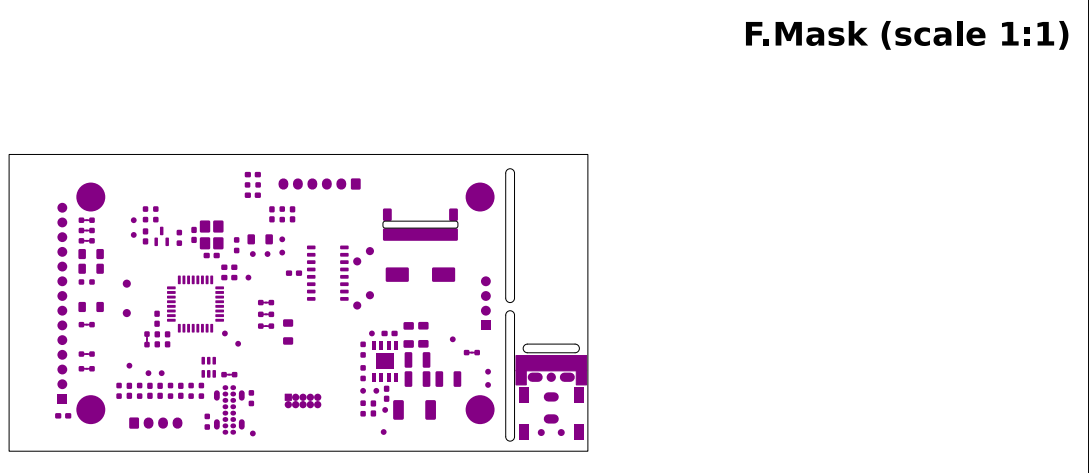
[picture p30: page 11]
Mat:; ktest.kicad_pcb; FLR; Rev'd:; Drwn:; Desk controller; Rls'd:; Concept; Notes; Sheet: F.Mask (scale 1:1); File:; Rev:; Date: 06/10/2026

# B.Mask (scale 1:1)

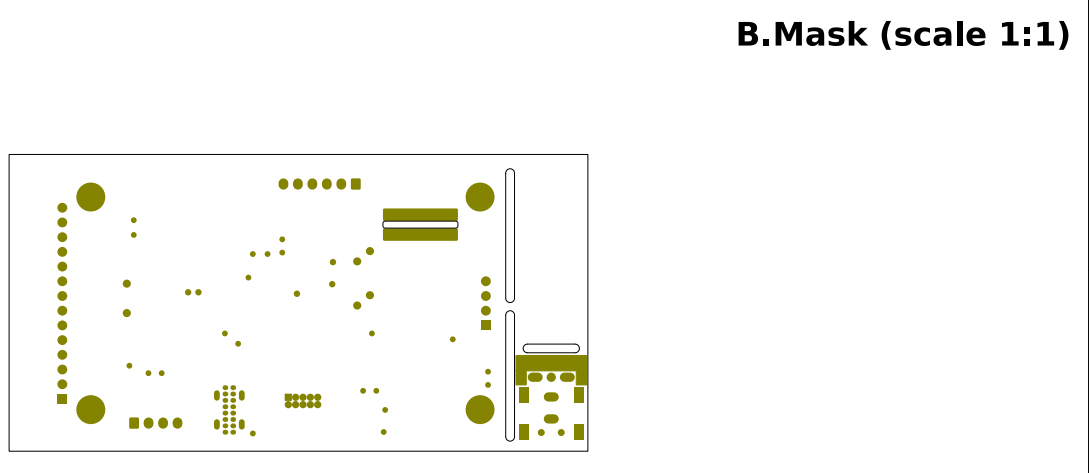
[picture p31: page 12]
Mat:; ktest.kicad_pcb; FLR; Rev'd:; Drwn:; Desk controller; Rls'd:; Concept; Notes; Sheet: B.Mask (scale 1:1); File:; Rev:; Date: 06/10/2026

# F.Silkscreen (scale 1:1)

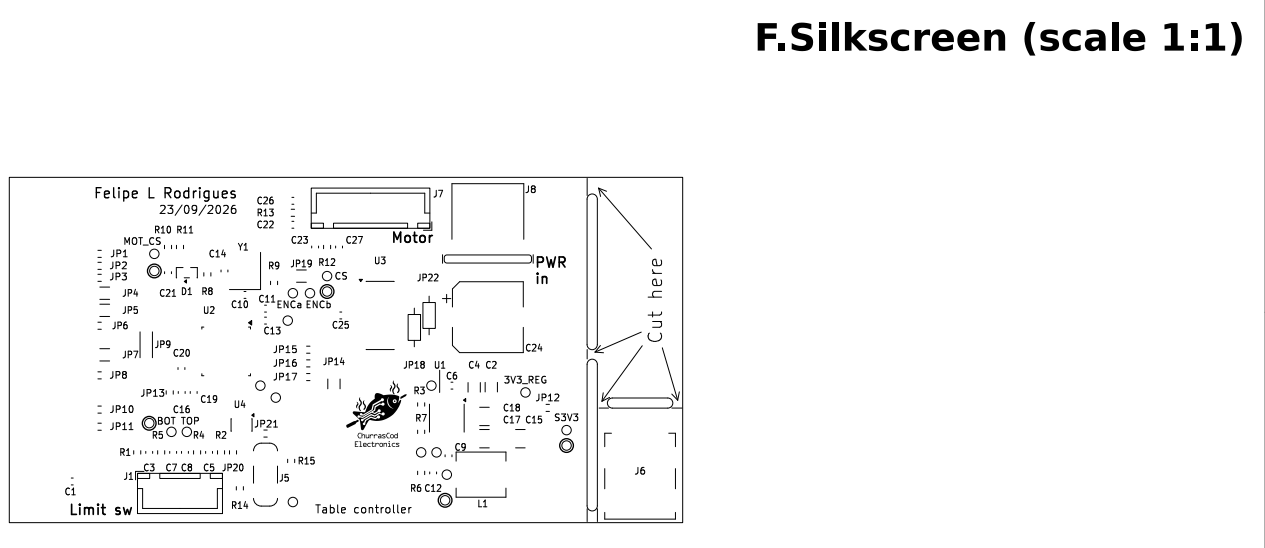
[picture p32: page 13]

# B.Silkscreen (scale 1:1)

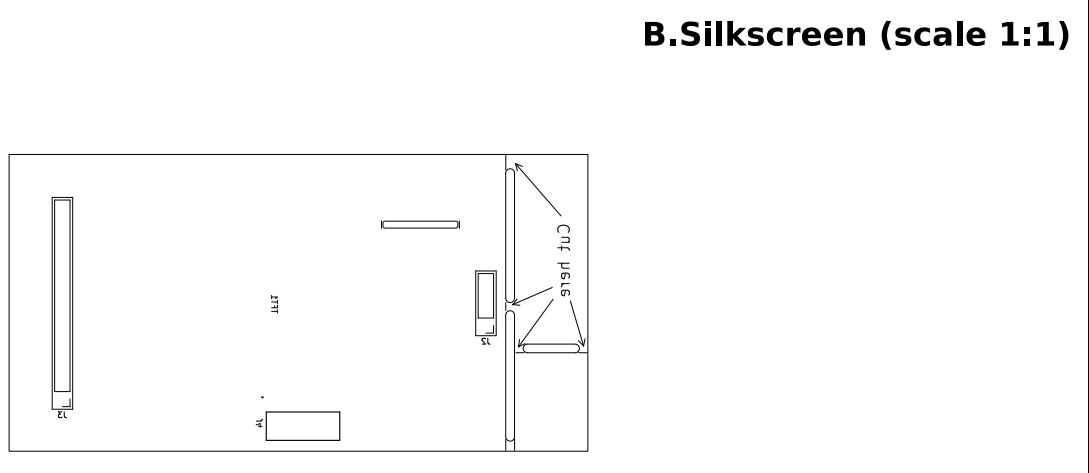
[picture p33: page 14]
Mat:; ktest.kicad_pcb; FLR; Rev'd:; Drwn:; Desk controller; Rls'd:; Concept; Notes; Sheet: B.Silkscreen (scale 1:1); File:; Rev:; Date: 06/10/2026; 6 TFT1; Cut here
