FLRHW/ktest/output/reports/browse/images/cat_pcb_assembly_pdf_ktest-pcb-assembly.png

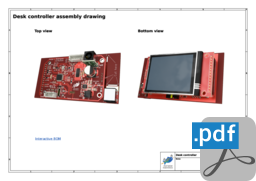
output/reports/browse/images/cat_pcb_assembly_pdf_ktest-pcb-assembly.png
