FLRHW/ktest/output/reports/browse/images/cat_pcb_fabrication_pdf_ktest-pcb-fabrication.png

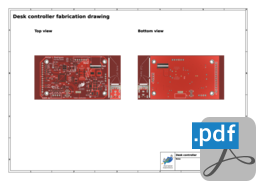
output/reports/browse/images/cat_pcb_fabrication_pdf_ktest-pcb-fabrication.png
