FLRHW/ktest/output/reports/browse/images/cat_testpoints_pdf_ktest-testpoints.png

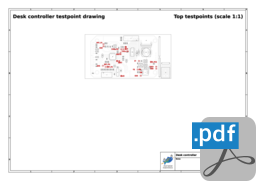
output/reports/browse/images/cat_testpoints_pdf_ktest-testpoints.png
