FLRHW/ktest/output/ktest-schematic.pdf

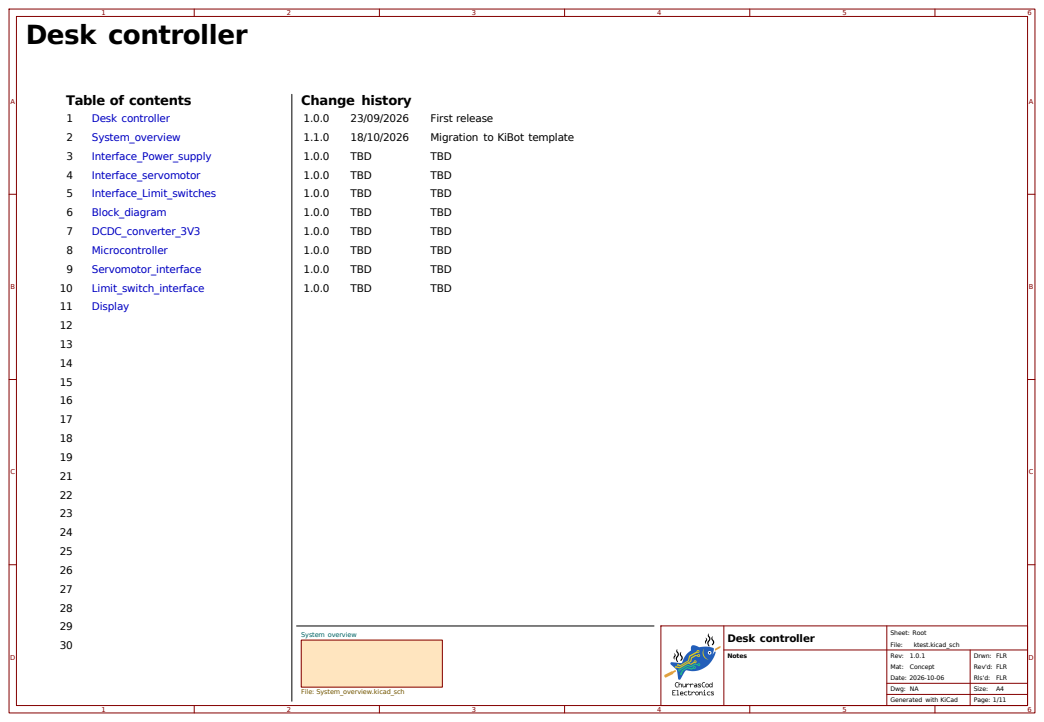
[picture p37: page 1]

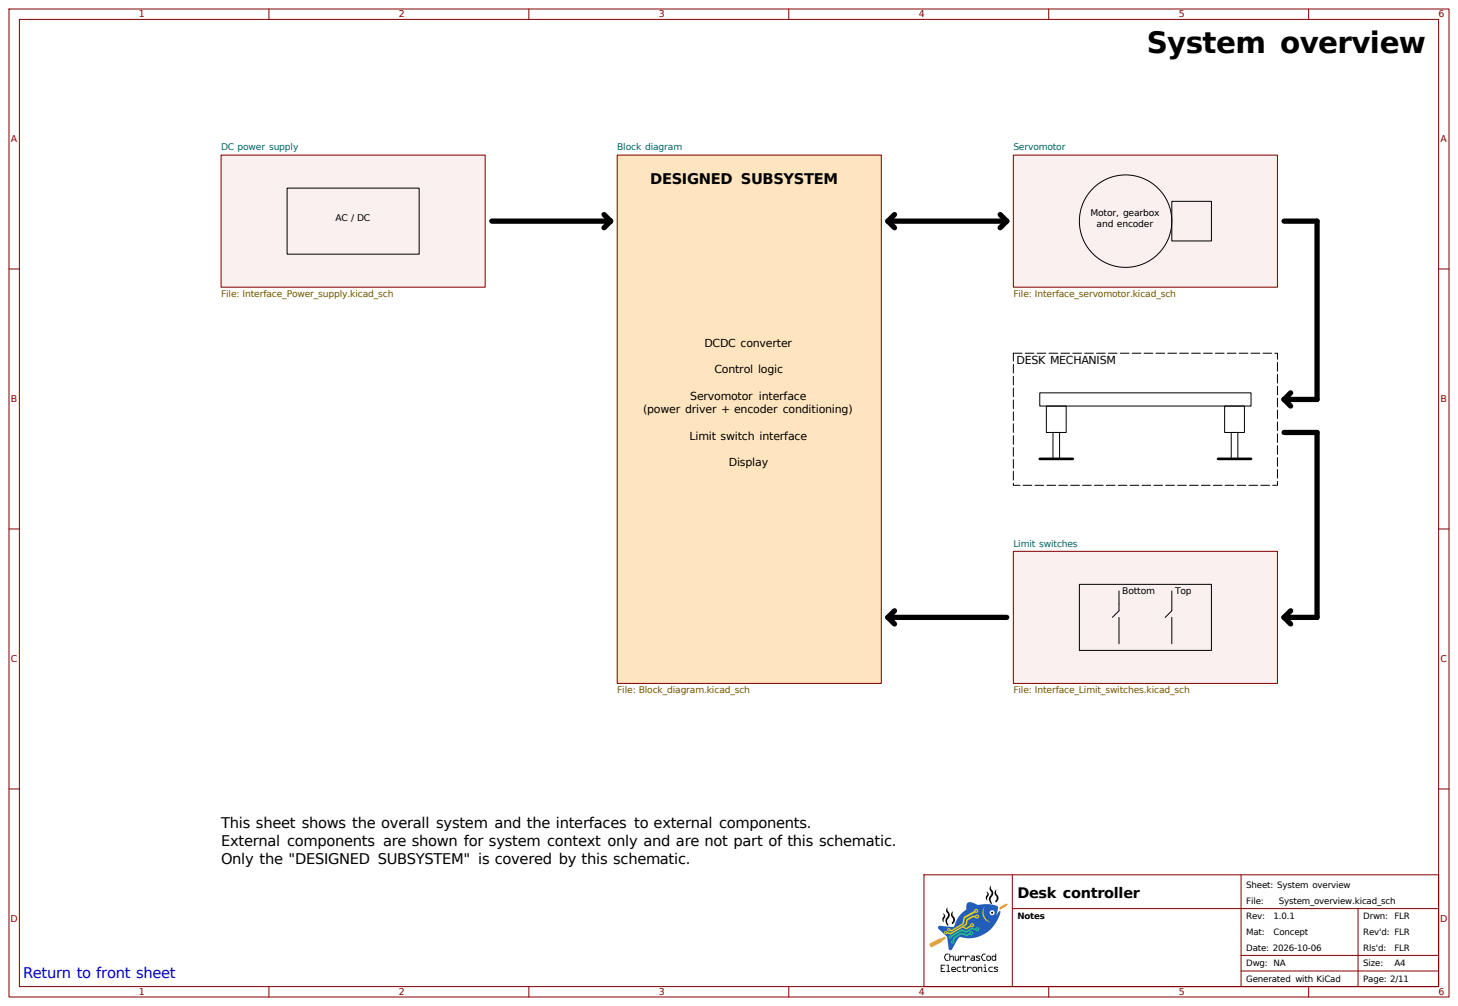
[picture p38: page 2]

Motor, gearbox and encoder

DCDC converter Control logic

(power driver + encoder conditioning)

This sheet shows the overall system and the interfaces to external components.
External components are shown for system context only and are not part of this schematic.
Only the "DESIGNED SUBSYSTEM" is covered by this schematic.

Return to front sheet

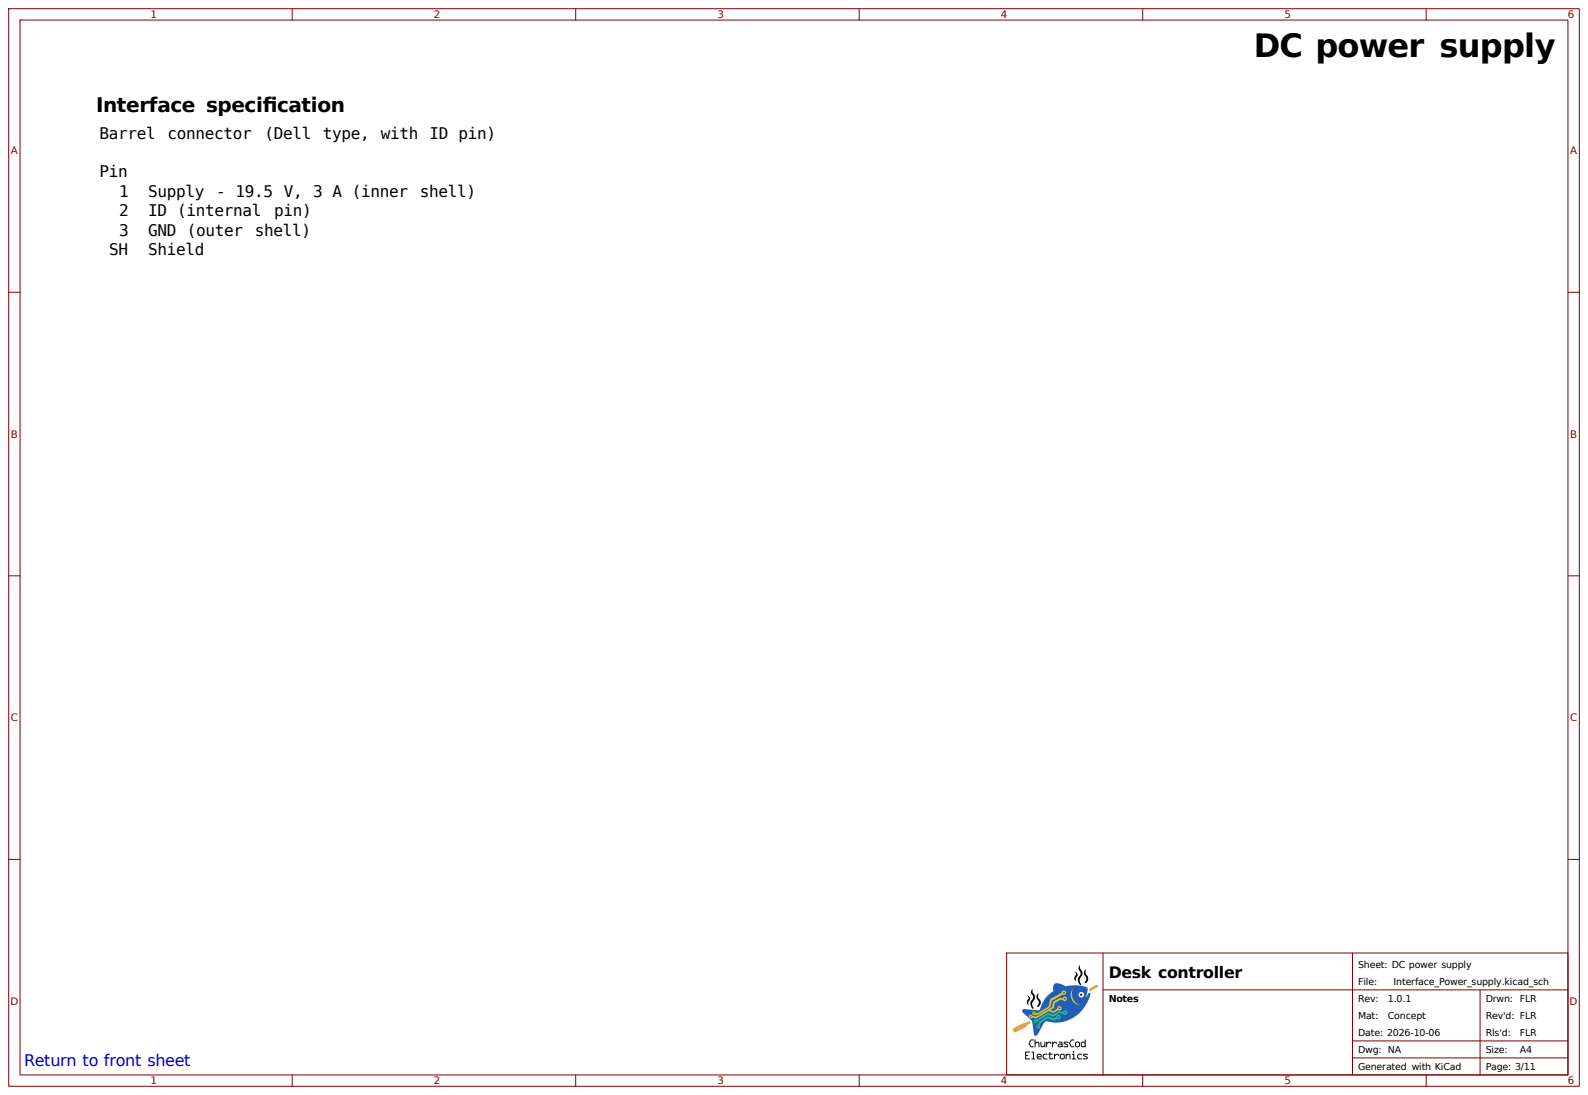
[picture p39: page 3]

Interface specification
Barrel connector (Dell type, with ID pin)

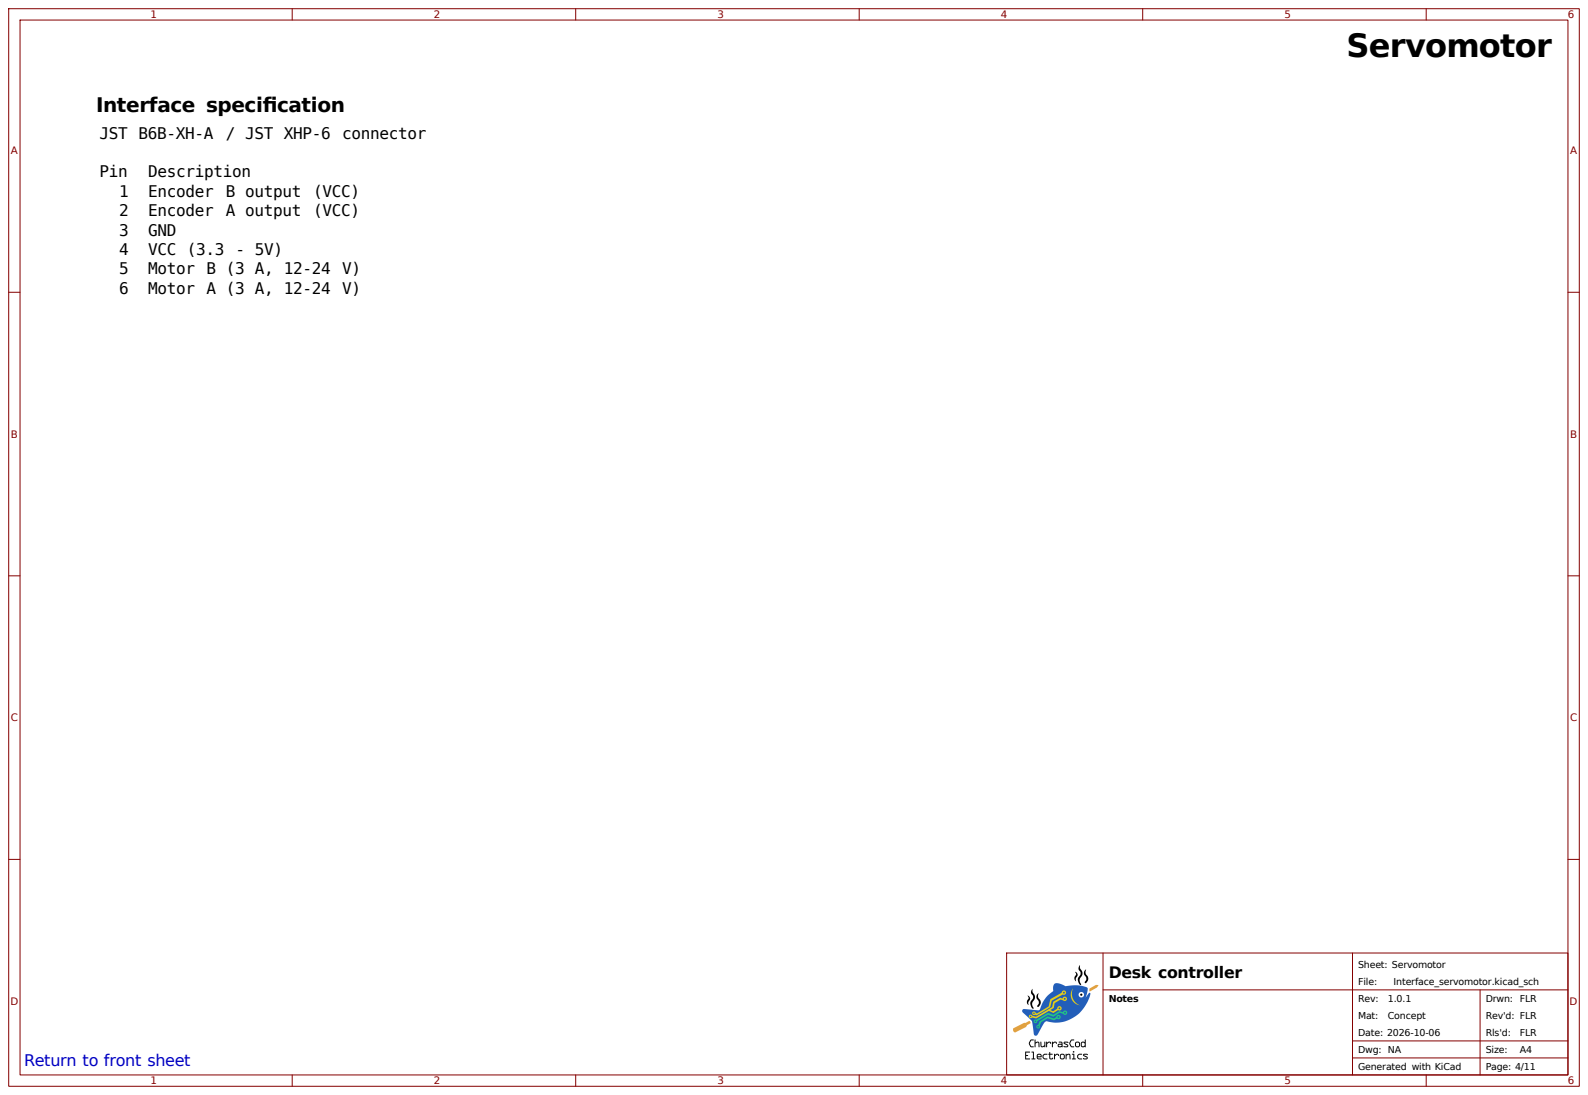
[picture p40: page 4]

Interface specification
JST B6B-XH-A / JST XHP-6 connector

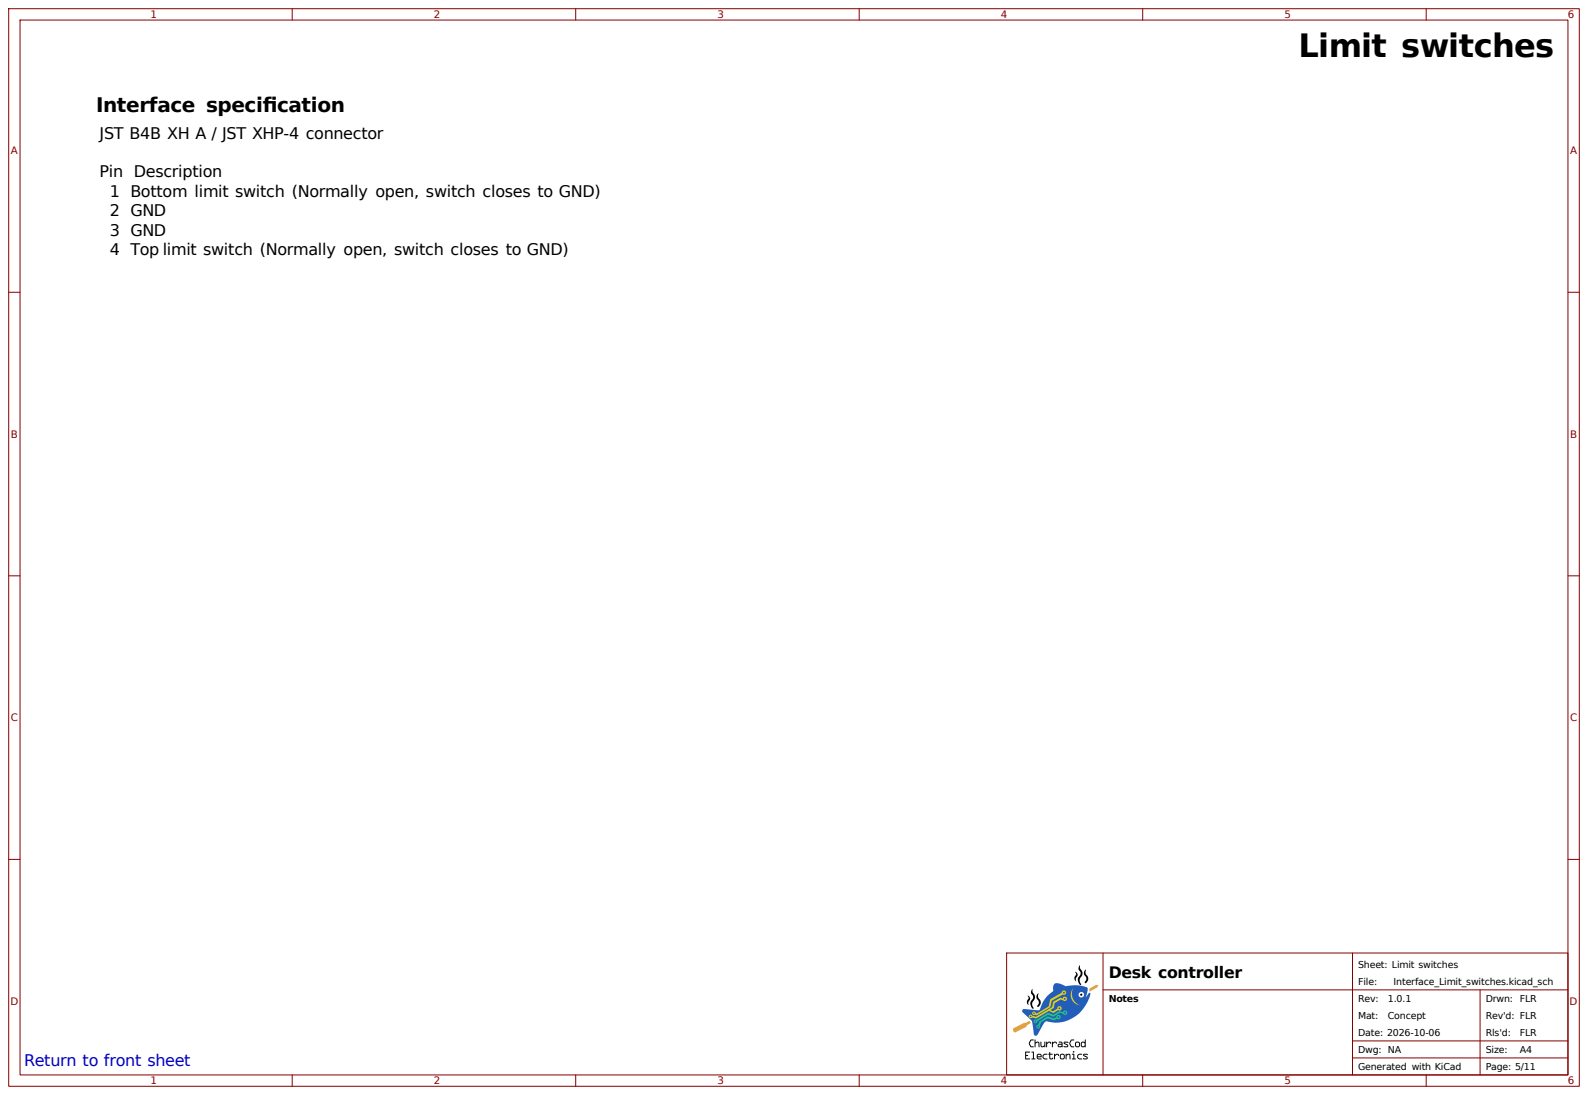
[picture p41: page 5]

Interface specification
JST B4B XH A / JST XHP-4 connector

Pin Description
1 Bottom limit switch (Normally open, switch closes to GND)
2 GND
3 GND
4 Top limit switch (Normally open, switch closes to GND)

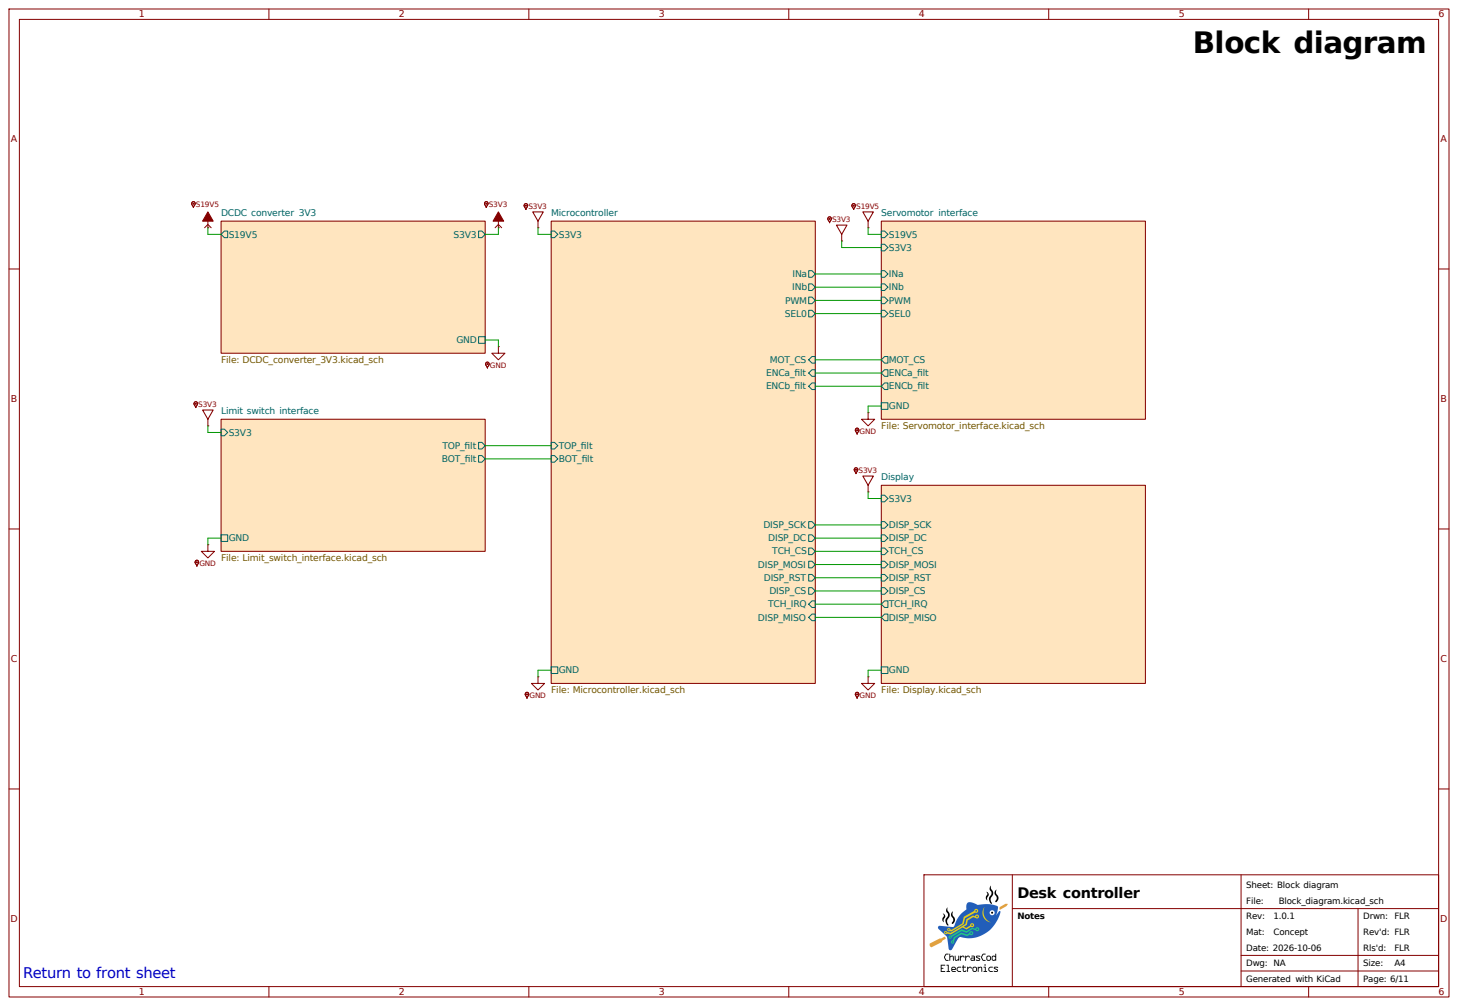
[picture p42: page 6]

S3V3 Return to front sheet

File: Sheet: Block diagram

Notes | Block_diagram.kicad_sch Dwg: NA Date: 2026-10-06 Generated with KiCad Rev: Concept | Size: Page: 6/11 Drwn: Rev'd: FLR FLR FLR

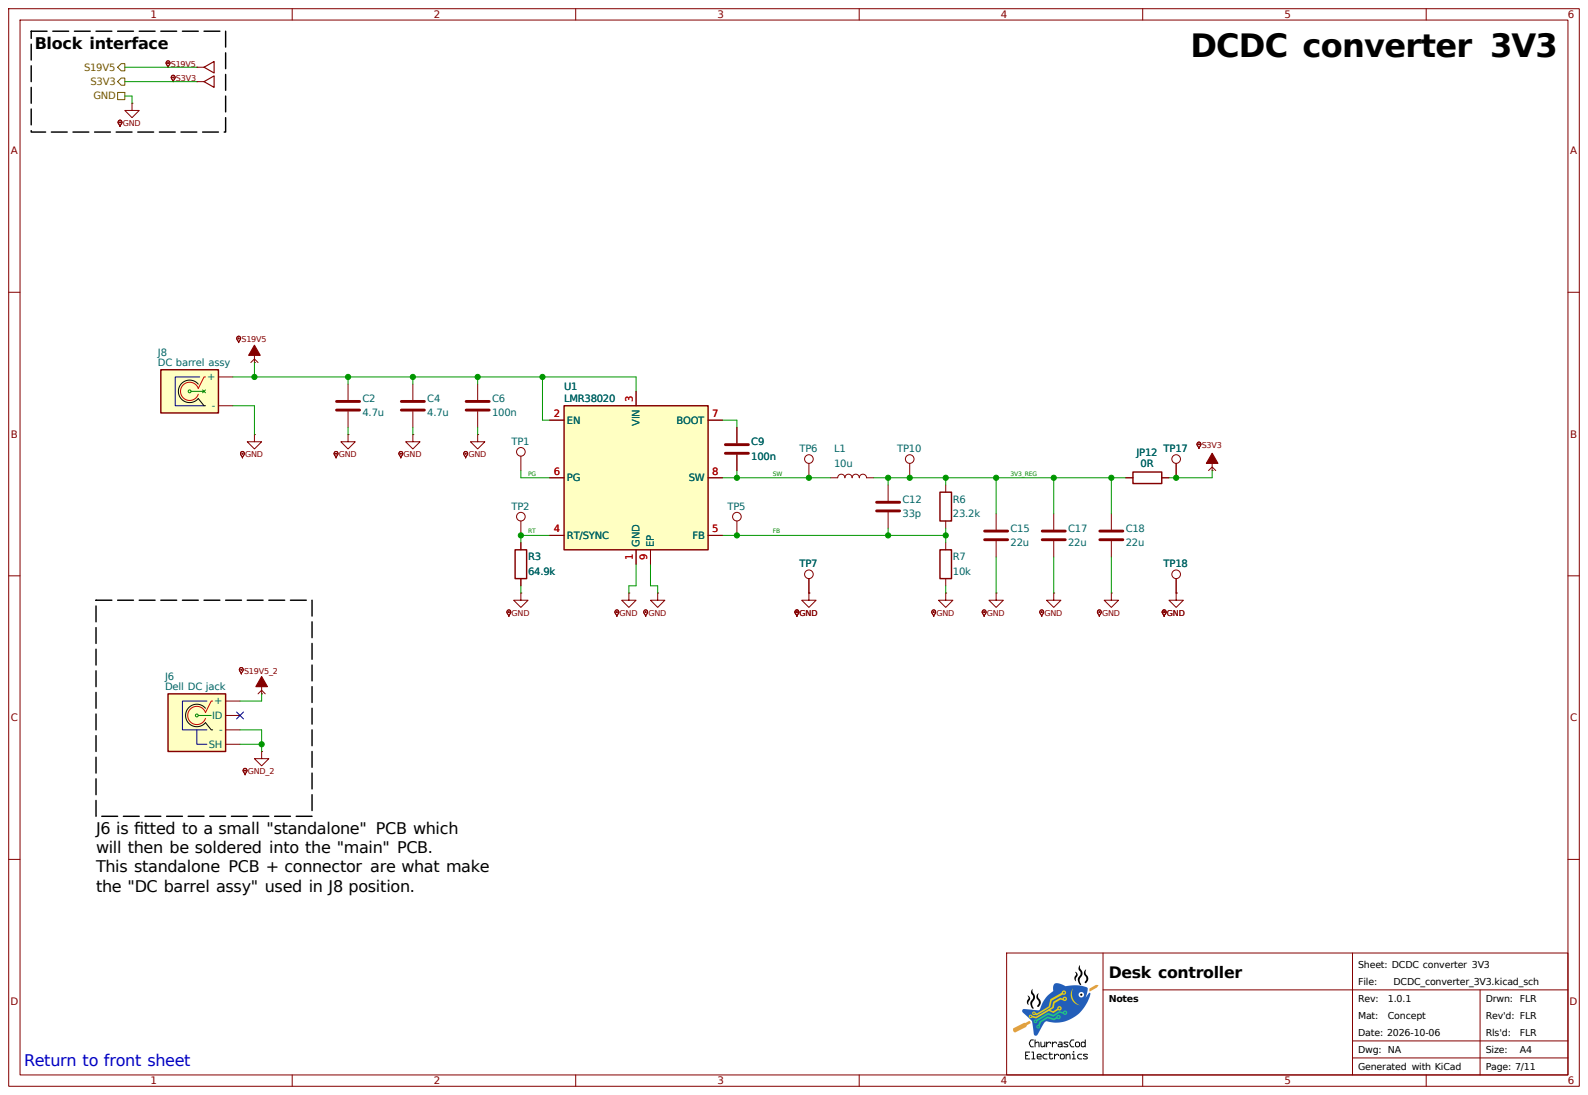
[picture p43: page 7]

RT J6 is fitted to a small "standalone" PCB which

will then be soldered into the "main" PCB.
This standalone PCB + connector are what make
the "DC barrel assy" used in J8 position.

Drwn: Rev'd: FLR DCDC_converter_3V3.kicad_sch Dwg: NA

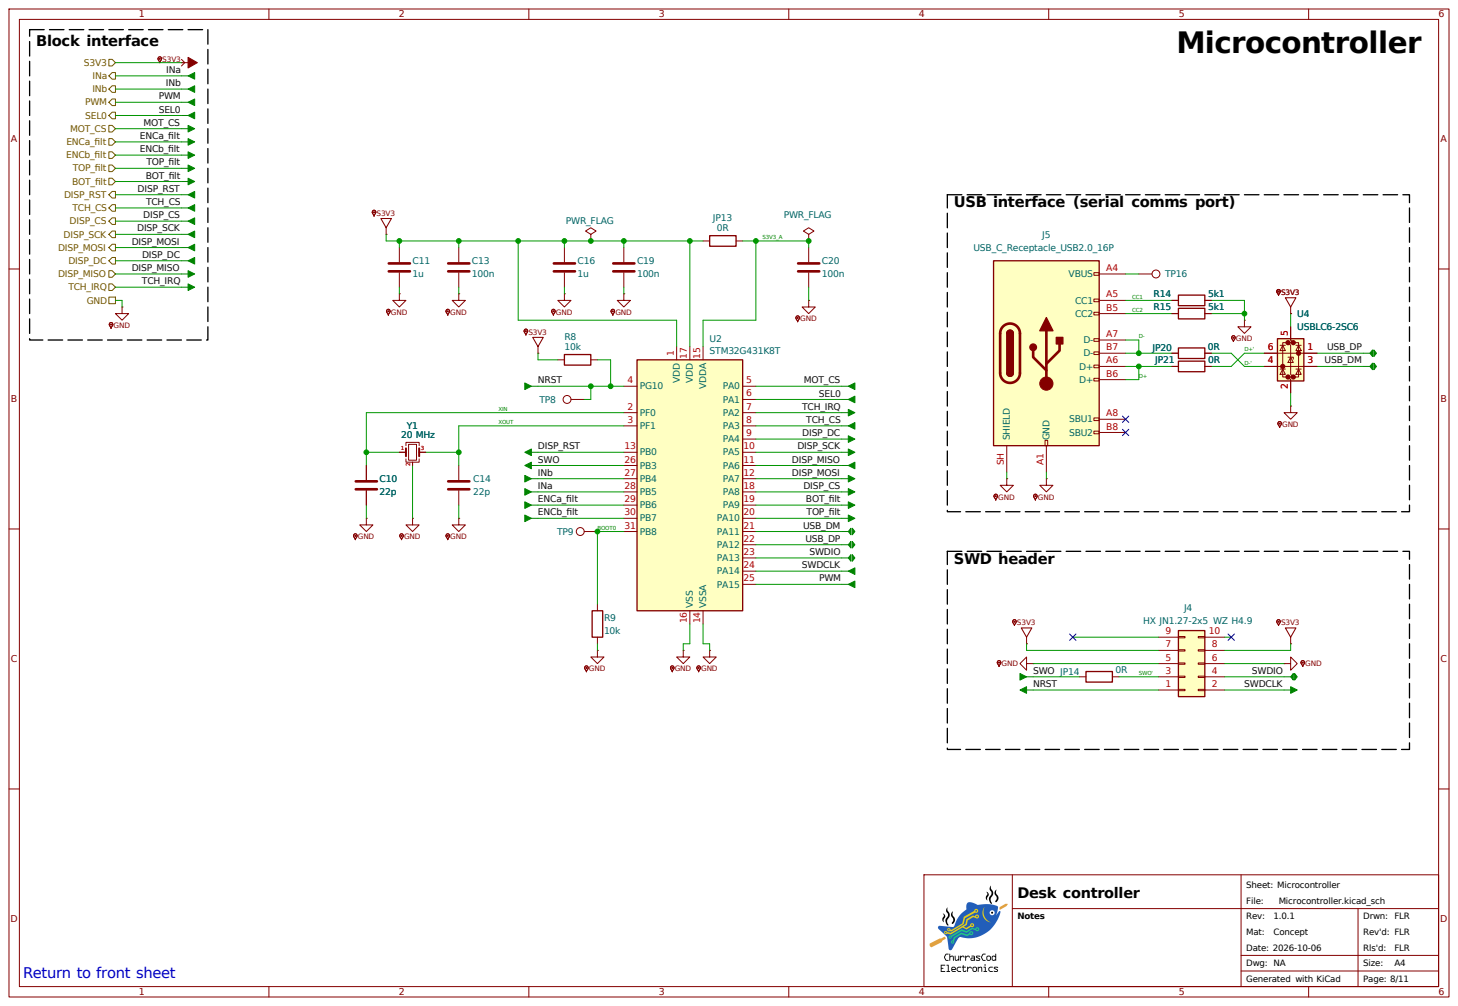
[picture p44: page 8]

USB interface (serial comms port)

Drwn: Rev'd: FLR Microcontroller.kicad_sch Dwg: NA

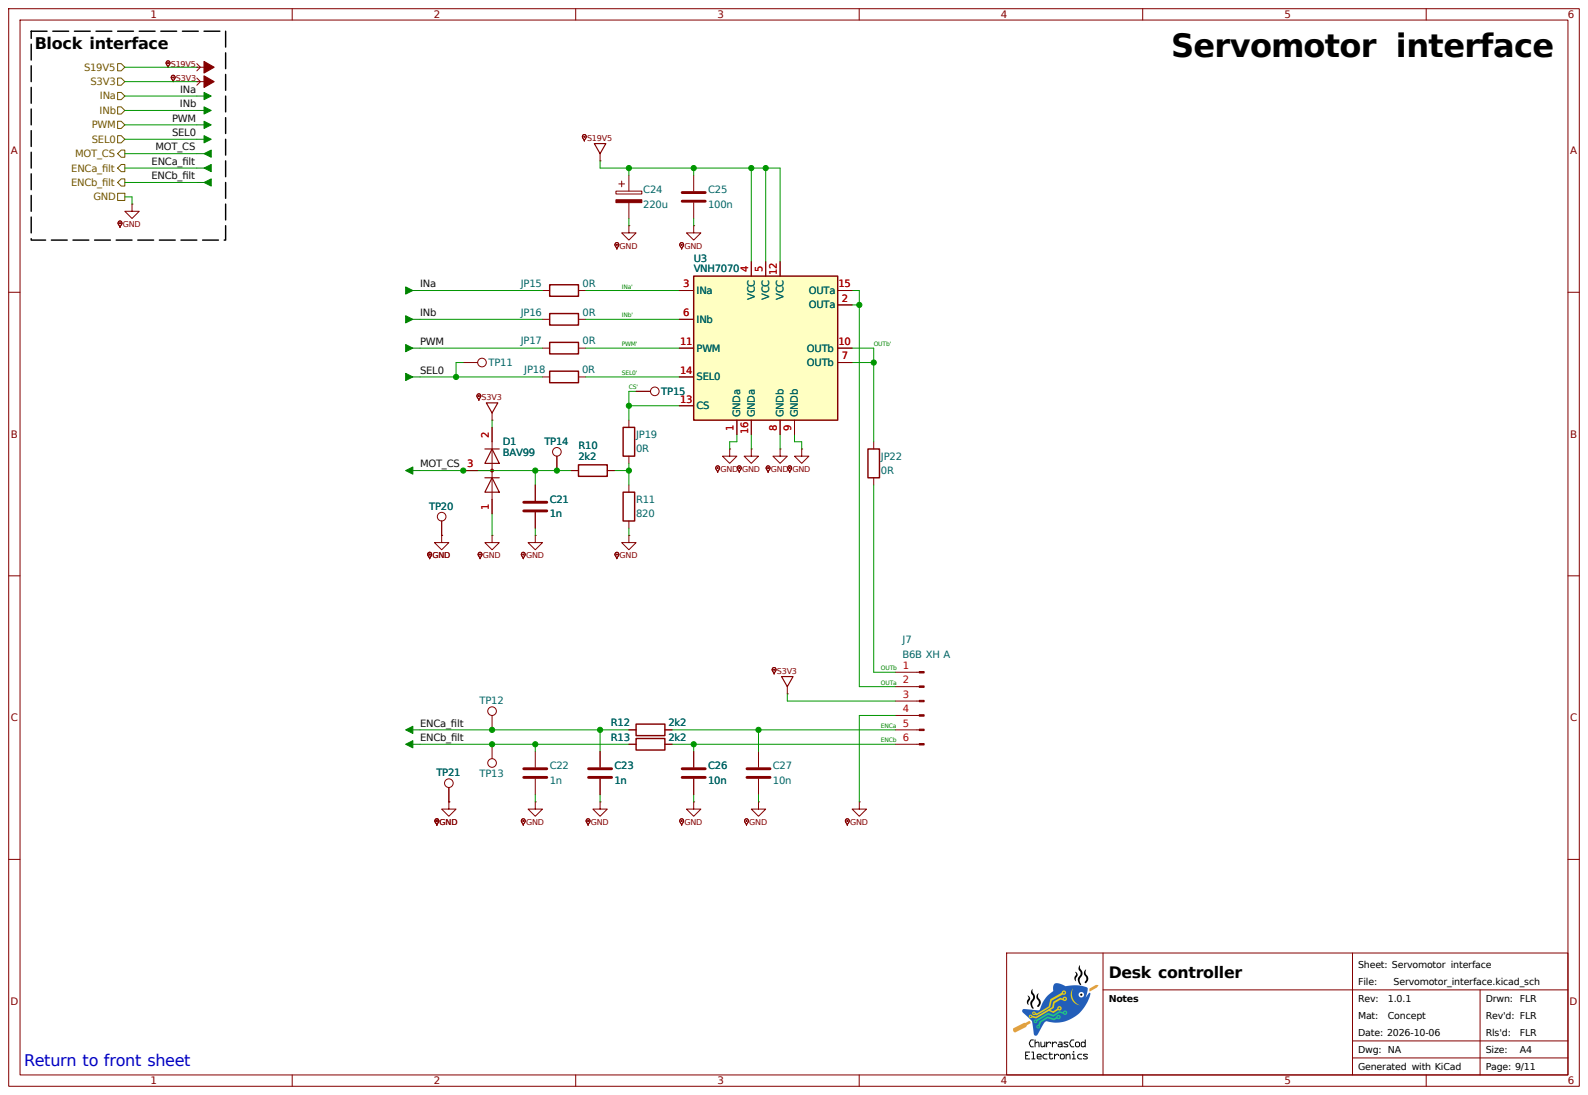
[picture p45: page 9]

INa' Return to front sheet

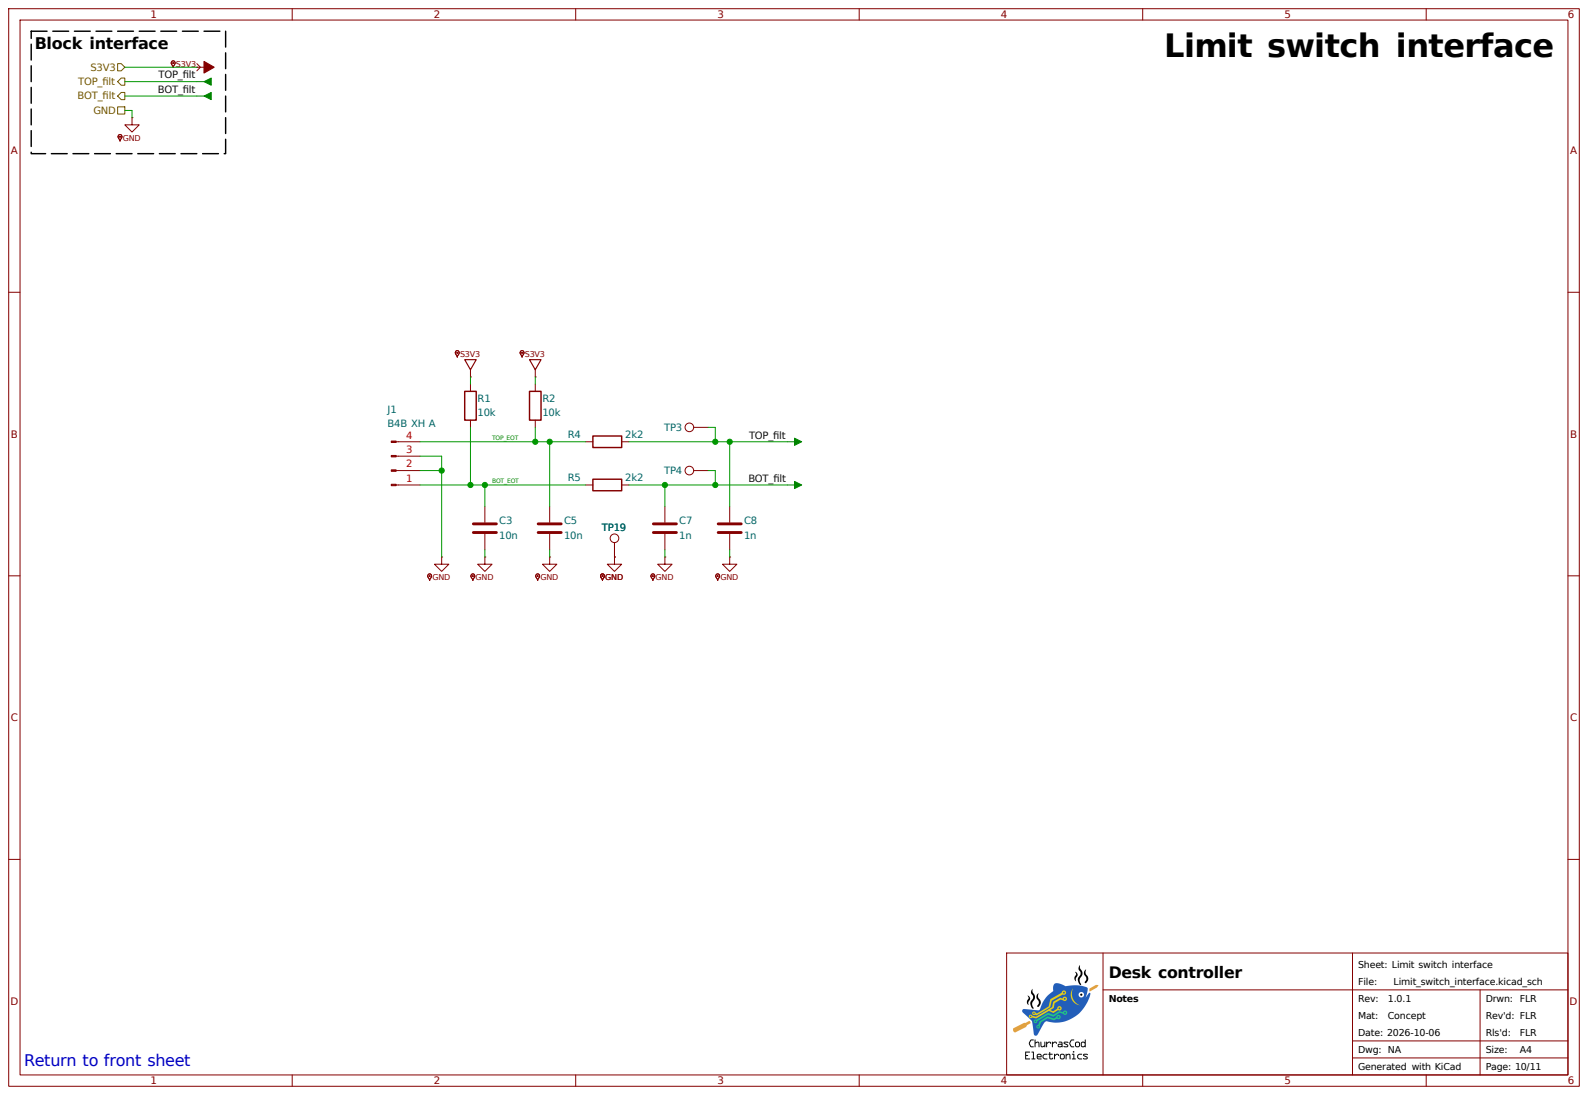
[picture p46: page 10]

TOP_EOT Return to front sheet

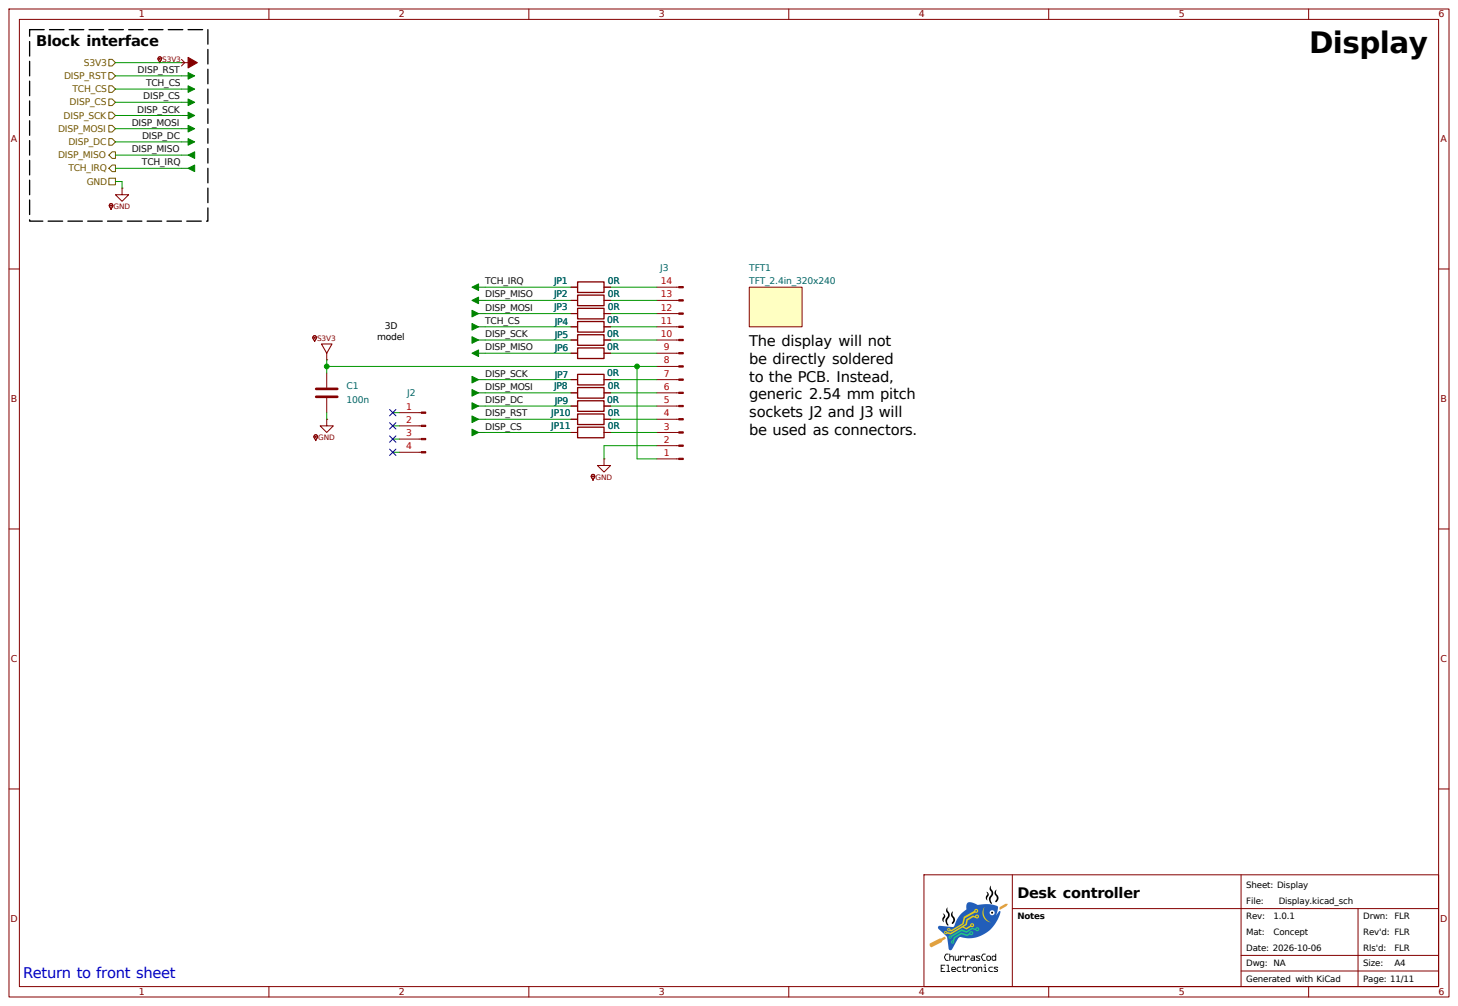
[picture p47: page 11]

The display will not
be directly soldered
to the PCB. Instead,
generic 2.54 mm pitch
sockets J2 and J3 will

Drwn: Rev'd: FLR Display.kicad_sch Dwg: NA
