FLRHW/ktest/(commit log)

2026-09-27 Add KiCad CI environment check
2026-09-27 Check schematic and PCB with KiBot
2026-09-27 add r1 c1 vlaue
    [ktest.kicad_pcb]
2026-09-27 Generate schematic PDF
2026-09-27 Use KiBot 1.9.1 with KiCad 10.0.5
2026-09-27 pcb pdf
2026-09-29 Pin GitHub Actions versions
2026-09-29 Generate Gerber and drill files
2026-09-29 Update KiBot outputs
    [ktest-B_Cu.gbl, ktest-B_Mask.gbs, ktest-B_Paste.gbp, ktest-B_Silkscreen.gbo, ktest-Edge_Cuts.gm1, ktest-F_Cu.gtl, ktest-F_Mask.gts, ktest-F_Paste.gtp]
2026-09-29 added holes
    [ktest.kicad_pcb]
2026-09-29 Add draft Blender board render
2026-09-29 4 layers
    [ktest.kicad_pcb, ktest.kicad_sch]
2026-09-30 updating sheet templates
    [ktest.kicad_sch]
2026-09-30 Keep local changes
    [ktest.kicad_pcb]
2026-10-01 pdf assy image
    [ktest.kicad_pcb]
2026-10-01 reposition png
    [ktest.kicad_pcb]
2026-10-01 rotate render
    [ktest.kicad_pcb]
2026-10-01 update fab doc
    [ktest.kicad_pcb]
2026-10-01 testing sch titleblock issue
    [config.kibot.yaml]
2026-10-01 adding tables
    [ktest.kicad_pcb]
2026-10-02 low res render option
    [ktest.kicad_pcb]
2026-10-02 automatic light neergy
    [ktest.kicad_pcb]
2026-10-02 lighting tweak
    [ktest.kicad_pcb]
2026-10-02 bare board render
    [ktest.kicad_pcb]
2026-10-02 fab and assy docs update
    [ktest.kicad_pcb, ktest.kicad_sch]
2026-10-02 two light sources
    [ktest.kicad_pcb]
2026-10-02 extra light source
    [ktest.kicad_pcb, ktest.kicad_sch]
2026-10-02 drc mismatch
    [ktest.kicad_pcb]
2026-10-03 script update
    [ktest.kicad_sch]
2026-10-03 insert ibom link to pdf assy
    [ktest.kicad_pcb]
2026-10-03 link appearance update
    [ktest.kicad_pcb]
2026-10-03 ibom update
    [ktest.kicad_pcb]
2026-10-03 testing render samples
2026-10-03 testing hierarchical sheets
    [child_1.kicad_sch, ktest.kicad_pcb, ktest.kicad_sch]
2026-10-03 fix drc issue
    [ktest.kicad_pcb]
2026-10-03 test dnp
    [child_1.kicad_sch, ktest.kicad_pcb, ktest.kicad_sch]
2026-10-03 mark dnp as red cross
    [ktest.kicad_pcb]
2026-10-03 test longer bom
    [child_1.kicad_sch, ktest.kicad_pcb, ktest.kicad_sch]
2026-10-03 test longer bom2
    [child_1.kicad_sch]
2026-10-03 new wks template
    [ktest.kicad_pcb, ktest.kicad_sch]
2026-10-03 new wks template3
    [ktest.kicad_pcb]
2026-10-03 new wks template4
    [ktest.kicad_pcb]
2026-10-04 tsting bom distance to titlebox
2026-10-04 solder mask check
2026-10-04 testing solder mask
2026-10-04 testing no bom
2026-10-04 no material enhancement test
2026-10-04 change wks for board
2026-10-04 change folder structure
    [ktest.kicad_pcb]
2026-10-06 out location update
    [ktest-B_Cu.gbl, ktest-B_Mask.gbs, ktest-B_Paste.gbp, ktest-B_Silkscreen.gbo, ktest-Edge_Cuts.gm1, ktest-F_Cu.gtl, ktest-F_Mask.gts, ktest-F_Paste.gtp]
2026-10-06 new script
    [ktest-(L1-L4)_NPTH_drill_table.csv, ktest-(L1-L4)_drill_table.csv, ktest-assembly-bom-bottom-dnp.csv, ktest-assembly-bom-bottom-fitted.csv, ktest-assembly-bom-bottom.csv, ktest-assembly-bom-top-dnp.csv, ktest-assembly-bom-top-fitted.csv, ktest-assembly-bom-top.csv]
2026-10-06 testing erc bypass
    [ktest.kicad_pcb, ktest.kicad_sch]
2026-10-06 testing both erc drc overlay
    [ktest.kicad_pcb, ktest.kicad_sch]
2026-10-06 reorganising structure
    [ktest-(L1-L4)_NPTH_drill_table.csv, ktest-(L1-L4)_drill_table.csv, ktest-3D.step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]
2026-10-06 testing drc bypass only
    [ktest.kicad_pcb, ktest.kicad_sch]
2026-10-06 merging scripts
    [ktest.kicad_pcb, ktest.kicad_sch]
2026-10-06 chekcing fonts
    [ktest-(L1-L4)_NPTH_drill_table.csv, ktest-assembly-bom-bottom-dnp.csv, ktest-assembly-bom-bottom-fitted.csv, ktest-assembly-bom-bottom.csv, ktest-assembly-bom-top-dnp.csv, ktest-assembly-count-bottom.csv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]
2026-10-06 detailing schematic
    [Block_diagram.kicad_sch, System_overview.kicad_sch, ktest.kicad_sch]
2026-10-07 creating hierarchy
    [Block_diagram.kicad_sch, System_overview.kicad_sch, child_1.kicad_sch, ktest.kicad_pcb]
2026-10-07 testing links
    [Block_diagram.kicad_sch, System_overview.kicad_sch, child_1.kicad_sch, ktest.kicad_sch]
2026-10-07 system overview and interfaces done
    [Block_diagram.kicad_sch, Interface_Limit_switches.kicad_sch, Interface_Power_supply.kicad_sch, Interface_servomotor.kicad_sch, System_overview.kicad_sch, child_1.kicad_sch, ktest.kicad_sch]
2026-10-07 fixing sheet names
    [ktest.kicad_pcb]
2026-10-07 testing render w red board
2026-10-08 testing green mask
    [Block_diagram.kicad_sch, Interface_Limit_switches.kicad_sch, Interface_Power_supply.kicad_sch, Interface_servomotor.kicad_sch, System_overview.kicad_sch, ktest.kicad_pcb, ktest.kicad_sch]
2026-10-08 testing blue mask
    [Block_diagram.kicad_sch, ktest.kicad_pcb, ktest.kicad_sch]
2026-10-08 testing other colour
    [Block_diagram.kicad_sch, ktest.kicad_pcb]
2026-10-08 testing yellow
    [ktest.kicad_pcb]
2026-10-08 dianosnig materials
    [ktest.kicad_pcb]
2026-10-08 jst correction attempt
    [Block_diagram.kicad_sch, ktest.kicad_pcb]
2026-10-08 connector only
2026-10-08 testing white
    [ktest.kicad_pcb]
2026-10-08 testing khronos
    [ktest-(L1-L4)_NPTH_drill_table.csv, ktest-(L1-L4)_drill_table.csv, ktest-assembly-bom-bottom-dnp.csv, ktest-assembly-bom-bottom-fitted.csv, ktest-assembly-bom-bottom.csv, ktest-assembly-bom-top-dnp.csv, ktest-assembly-bom-top-fitted.csv, ktest-assembly-bom-top.csv]
2026-10-08 refining hierarchy
    [Block_diagram.kicad_sch, Limit_switch_interface.kicad_sch, Microcontroller.kicad_sch, Power_converter.kicad_sch, Servomotor_interface.kicad_sch, Touch_TFT.kicad_sch]
2026-10-08 append extra sheet
    [.kicad_sch, Block_diagram.kicad_sch, DCDC_converter_3V3.kicad_sch, old.kicad_sch]
2026-10-09 sch update
    [Block_diagram.kicad_sch, DCDC_converter_3V3.kicad_sch, Limit_switch_interface.kicad_sch, Microcontroller.kicad_sch, Servomotor_interface.kicad_sch, System_overview.kicad_sch, Touch_TFT.kicad_sch, ktest.kicad_sch]
2026-10-09 reorganised sch and pcb
    [Block_diagram.kicad_sch, DCDC_converter_3V3.kicad_sch, Interface_servomotor.kicad_sch, Microcontroller.kicad_sch, Servomotor_interface.kicad_sch, System_overview.kicad_sch, Touch_TFT.kicad_sch, ktest.kicad_pcb]
2026-10-09 checking theme
    [ktest.kicad_sch]
2026-10-09 updated sch template (A4)
    [Block_diagram.kicad_sch, DCDC_converter_3V3.kicad_sch, Display.kicad_sch, Interface_Limit_switches.kicad_sch, Interface_Power_supply.kicad_sch, Interface_servomotor.kicad_sch, Limit_switch_interface.kicad_sch, Microcontroller.kicad_sch]
2026-10-09 new sch size
    [Display.kicad_sch, System_overview.kicad_sch]
2026-10-09 adding more outputs
    [Display.kicad_sch, ktest.kicad_sch]
2026-10-10 adding libraries pt1
    [ktest.kicad_pcb]
2026-10-10 lib check1
    [ktest.kicad_pcb]
2026-10-10 lib check 2
    [ktest.kicad_pcb]
2026-10-10 updating display
    [ktest.kicad_pcb]
2026-10-10 testpoint pdf
    [ktest.kicad_pcb]
2026-10-10 update testpoint doc
    [ktest.kicad_pcb]
2026-10-10 more details on TP layers
    [ktest.kicad_pcb]
2026-10-10 add hmtl
    [ktest.kicad_pcb]
2026-10-10 testing disabled render
    [ktest-(L1-L4)_NPTH_drill_table.csv, ktest-(L1-L4)_drill_table.csv, ktest-3D.step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]
2026-10-10 supplier and mpn added
    [Block_diagram.kicad_sch, DCDC_converter_3V3.kicad_sch, Display.kicad_sch, Limit_switch_interface.kicad_sch, Microcontroller.kicad_sch, Servomotor_interface.kicad_sch, ktest.kicad_pcb]
2026-10-10 closing kicad
2026-10-10 changing exclude filter
2026-10-10 added lib tables
    [Block_diagram.kicad_sch, DCDC_converter_3V3.kicad_sch, Display.kicad_sch, Interface_Limit_switches.kicad_sch, Interface_Power_supply.kicad_sch, Interface_servomotor.kicad_sch, Limit_switch_interface.kicad_sch, Microcontroller.kicad_sch]
2026-10-10 reworked finalise pdf
    [ktest.kicad_pcb]
2026-10-10 updated logo
    [ktest.kicad_pcb]
